B1narySolutions/amp-hardware/audio-board/rev3/fab/assembly/seed3-carrier_bom.csv

Comment | Designator | Footprint | JLCPCB Part #
Daisy Seed3 | A1 | Module:Electrosmith_Daisy_Seed
100pF | C1,C18 | Capacitor_SMD:C_0603_1608Metric | C14858
47nF | C2 | Capacitor_SMD:C_0805_2012Metric | C22402129
1nF | C3,C9 | Capacitor_SMD:C_0603_1608Metric | C163508
100nF | C4,C6,C17 | Capacitor_SMD:C_0603_1608Metric | C14663
47uF 16V | C5 | Capacitor_THT:CP_Radial_D5.0mm_P2.00mm
47uF 16V | C7 | Capacitor_SMD:C_1210_3225Metric | C77101
470n 25V C0G | C10,C11,C22,C23,C108,C109 | Capacitor_SMD:C_1206_3216Metric | C6049896
1uF | C12,C13,C14,C15 | Capacitor_SMD:C_0805_2012Metric | C28323
3.3nF | C16 | Capacitor_SMD:C_0603_1608Metric | C2170675
10pF | C19,C20 | Capacitor_SMD:C_0603_1608Metric | C1634
10u 16V | C21 | Capacitor_SMD:C_0805_2012Metric | C15850
10u 10V | C103 | Capacitor_SMD:C_0805_2012Metric | C15850
100n 10V | C105,C107,C123 | Capacitor_SMD:C_0603_1608Metric | C14663
1u 16V | C110 | Capacitor_SMD:C_0805_2012Metric | C28323
100u 25V | C111,C112 | Capacitor_THT:CP_Radial_D6.3mm_P2.50mm
100n 50V | C113,C114 | Capacitor_SMD:C_0603_1608Metric | C14663
1u 25V | C115 | Capacitor_SMD:C_0805_2012Metric | C28323
100n 25V | C116 | Capacitor_SMD:C_0603_1608Metric | C14663
220n 25V | C117,C118,C119,C120 | Capacitor_SMD:C_0603_1608Metric | C21120
680n 50V X7R | C121,C122 | Capacitor_SMD:C_0805_2012Metric | C22402009
1u 10V | C124,C125 | Capacitor_SMD:C_0805_2012Metric | C28323
PESD5V0S1BA | D1,D2,D3,D4,D5 | Diode_SMD:D_SOD-323 | C19224
BZT52C12 | D101 | Diode_SMD:D_SOD-123 | C668891
BAT54H | D102,D103 | Diode_SMD:D_SOD-323 | C179609
T3.15A | F101 | Seed3_Carrier:Fuse_Bel_0683G_4818
600R GHz | FB1 | Inductor_SMD:L_0603_1608Metric | C85830
220R@100MHz | FB101,FB102 | Inductor_SMD:L_0603_1608Metric | C76815
NRJ4HF | J1 | Connector_Audio:Jack_6.35mm_Neutrik_NRJ4HF_Horizontal
SJ3-35063AG | J2,J4 | Seed3_Carrier:Jack_3.5mm_SameSky_SJ3-35063AG_Horizontal
DISPLAY_UART | J3 | TerminalBlock_Phoenix:TerminalBlock_Phoenix_PT-1,5-3-3.5-H_1x03_P3.50mm_Horizontal
PJ-102AH | J101 | Connector_BarrelJack:BarrelJack_CUI_PJ-102AH_Horizontal
SPEAKER | J102 | TerminalBlock_Phoenix:TerminalBlock_Phoenix_PT-1,5-2-3.5-H_1x02_P3.50mm_Horizontal
DISPLAY 5V | J105 | TerminalBlock_Phoenix:TerminalBlock_Phoenix_PT-1,5-2-3.5-H_1x02_P3.50mm_Horizontal
DFR IN | J106 | Connector_JST:JST_XH_S2B-XH-A_1x02_P2.50mm_Horizontal
DFR OUT | J107 | TerminalBlock_Phoenix:TerminalBlock_Phoenix_PT-1,5-2-3.5-H_1x02_P3.50mm_Horizontal
BYPASS | JP101,JP103 | Connector_PinHeader_2.54mm:PinHeader_1x02_P2.54mm_Vertical
BULK | JP102,JP104 | Connector_PinHeader_2.54mm:PinHeader_1x02_P2.54mm_Vertical
RESET | JP105 | Connector_PinHeader_2.54mm:PinHeader_1x02_P2.54mm_Vertical
10uH | L101,L102 | Halliquest_Power:L_Bourns_SRP1038A_LeadFrame | C780184
2N7002 | Q2 | Package_TO_SOT_SMD:SOT-23 | C551416
IRF4905 | Q101 | Package_TO_SOT_THT:TO-220-3_Vertical
AO3401A | Q102 | Package_TO_SOT_SMD:SOT-23 | C15127
1M | R1 | Resistor_SMD:R_0603_1608Metric | C22935
1k | R2,R11,R21,R30 | Resistor_SMD:R_0603_1608Metric | C21190
10k | R3,R4,R6,R7,R8,R9,R101,R107,R109,R112,R113 | Resistor_SMD:R_0603_1608Metric | C25804
470 | R5,R20 | Resistor_SMD:R_0603_1608Metric | C23179
3.3k | R10 | Resistor_SMD:R_0603_1608Metric | C22978
100k | R12,R17,R18,R19,R24,R34,R111 | Resistor_SMD:R_0603_1608Metric | C25803
2.2 | R29 | Resistor_SMD:R_0603_1608Metric | C22939
2.2k | R32,R33,R108,R110 | Resistor_SMD:R_0603_1608Metric | C4190
100k 1% | R102 | Resistor_SMD:R_0603_1608Metric | C25803
10k 1% | R103 | Resistor_SMD:R_0603_1608Metric | C25804
5.6k 1% | R104 | Resistor_SMD:R_0603_1608Metric | C23189
0R | R105 | Resistor_SMD:R_2512_6332Metric | C189505
10R | R106 | Resistor_SMD:R_0603_1608Metric | C22859
18k | R114 | Resistor_SMD:R_0603_1608Metric | C25810
SPST | SW101 | TerminalBlock_Phoenix:TerminalBlock_Phoenix_PT-1,5-2-3.5-H_1x02_P3.50mm_Horizontal
TP_HP_DET | TP1 | TestPoint:TestPoint_Pad_D2.0mm
VBAT_PROTECTED | TP101 | TestPoint:TestPoint_Pad_D2.0mm
GND | TP102,TP105,TP107,TP108 | TestPoint:TestPoint_Pad_D2.0mm
AMP_PVCC | TP103 | TestPoint:TestPoint_Pad_D2.0mm
AMP_SDZ | TP104 | TestPoint:TestPoint_Pad_D2.0mm
+5V_RAW | TP106 | TestPoint:TestPoint_Pad_D2.0mm
AMP_FAULTZ | TP109 | TestPoint:TestPoint_Pad_D2.0mm
TLV9061QDBVRQ1 | U1 | Package_TO_SOT_SMD:SOT-23-5 | C22439604
TPA6130A2RTJR | U2 | Package_DFN_QFN:WQFN-20-1EP_4x4mm_P0.5mm_EP2.7x2.7mm | C130046
TPA3118D2DAPR | U101 | Halliquest_Power:TI_DAP0032C_HTSSOP32_P0.65mm_EP3.04x3.74mm | C46497
DFR0571 | U102
TPS3808EG50DBVR | U103 | Package_TO_SOT_SMD:SOT-23-6 | C30139374
