B1narySolutions/amp-hardware/audio-board/rev3/seed3-carrier-digikey-cart.csv

Quantity | Digi-Key Part Number | Customer Reference
1 | 311-1.00MHRCT-ND | R1
4 | 311-1.00KHRCT-ND | R2 R11 R21 R30
12 | RMCF0603FT10K0CT-ND | R3 R4 R6 R7 R8 R9 R101 R103 R107 R109 R112 ...
1 | RMCF0603FT18K0CT-ND | R114
1 | RMCF0603FT2R20CT-ND | R29
2 | 311-470HRCT-ND | R5 R20
1 | 311-3.30KHRCT-ND | R10
8 | RMCF0603FT100KCT-ND | R12 R17 R18 R19 R24 R34 R111 R102
1 | 311-5.60KHRCT-ND | R104
1 | RMCF0603FT10R0CT-ND | R106
4 | 311-2.20KHRCT-ND | R32 R33 R108 R110
2 | 1276-1008-1-ND | C1 C18
2 | 1276-1027-1-ND | C19 C20
1 | 399-C0805C473J3GACTUCT-ND | C2
1 | 490-1033-1-ND | FB1
2 | 1276-1091-1-ND | C3 C9
1 | 399-C0603C332J5GACTUCT-ND | C16
9 | 399-C0603C104K5RACTUCT-ND | C4 C6 C17 C105 C107 C113 C114 C116 C123
4 | 1276-CL10B224KB8NNNCCT-ND | C117 C118 C119 C120
8 | 399-C0805C105K5RACTUCT-ND | C12 C13 C14 C15 C110 C115 C124 C125
2 | 478-KGM21AR71C106KUCT-ND | C21 C103
6 | 490-GRM31C5C1E474JE01LCT-ND | C10 C11 C22 C23 C108 C109
2 | 399-C0805C684K5RACTUCT-ND | C121 C122
1 | 732-8628-1-ND | C5
1 | 490-6539-1-ND | C7
5 | 1727-PESD5V0S1BAFCT-ND | D1 D2 D3 D4 D5
2 | NSVBAT54HT1GOSCT-ND | D102 D103
1 | 6473-NRJ4HF-ND | J1
2 | 2223-SJ3-35063AG-ND | J2 J4
1 | 277-1722-ND | J3
4 | 277-1721-ND | J102 J105 J107 SW101
1 | 455-S2B-XH-A-ND | J106
1 | 455-2266-ND | J106 mate (DFR0571 input cable)
1 | 455-3241-ND | J106 cable leads (cut in half)
1 | 785-1001-1-ND | Q102
1 | 1727-8643-1-ND | Q2
1 | 296-TLV9061QDBVRQ1CT-ND | U1
1 | 296-21656-1-ND | U2
2 | S7018-ND | A1
4 | 10-EEU-FM1E101HCT-ND | C111 C112; C104 C106 optional
1 | YAG1232CT-ND | R105
1 | BZT52C12-TPMSCT-ND | D101
1 | IRF4905PBF-ND | Q101
1 | 296-38572-1-ND | U101
1 | 296-TPS3808EG50DBVRCT-ND | U103
2 | 445-MPZ1608S221ATA00CT-ND | FB101 FB102
2 | SRP1038A-100MCT-ND | L101 L102
1 | CP-102AH-ND | J101
5 | 952-2261-ND | JP101 JP102 JP103 JP104 JP105
4 | 952-2171-ND | JP101 JP102 JP103 JP104 shunts
1 | 5923-0683G3150-01CT-ND | F101
1 | 6281-S1B-ND | panel switch to SW101
1 | 1738-1442-ND | U102 off-board
