B1narySolutions/amp-hardware/audio-board/3dmodels/Bourns_PTV09A-4020F_placeholder.step

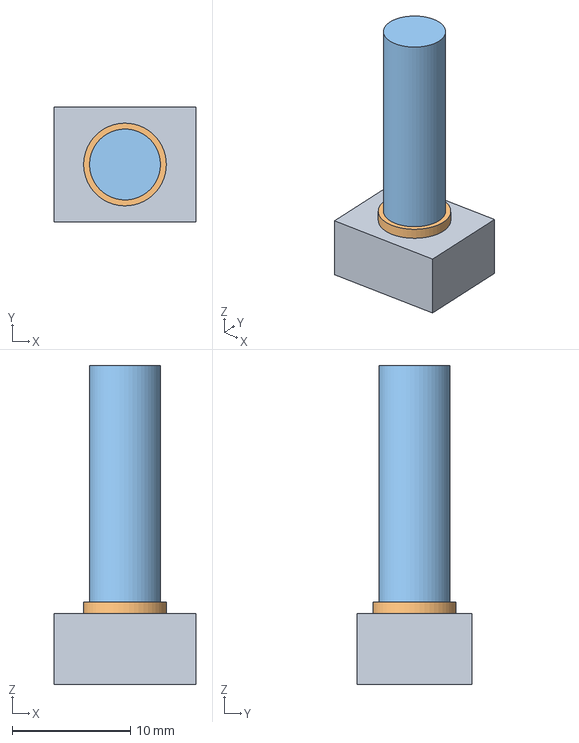
[picture p5: CAD file, 2026-10-25]
audio-board/3dmodels/Bourns_PTV09A-4020F_placeholder.step
12.0 x 9.70 x 27.0 mm
