B1narySolutions/amp-hardware/audio-board/3dmodels/Electrosmith_Daisy_Seed_placeholder.step

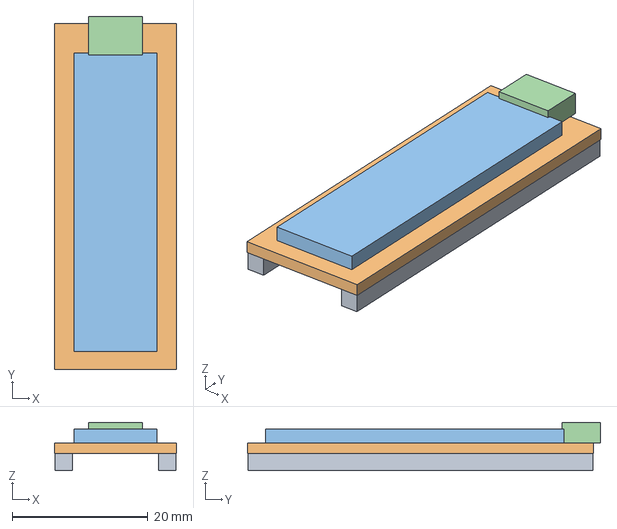
[picture p7: CAD file, 2026-10-25]
audio-board/3dmodels/Electrosmith_Daisy_Seed_placeholder.step
18.0 x 52.0 x 7.10 mm
