B1narySolutions/amp-hardware/legacy/audio-board/3dmodels/SameSky_SJ3-35063AG_placeholder.step

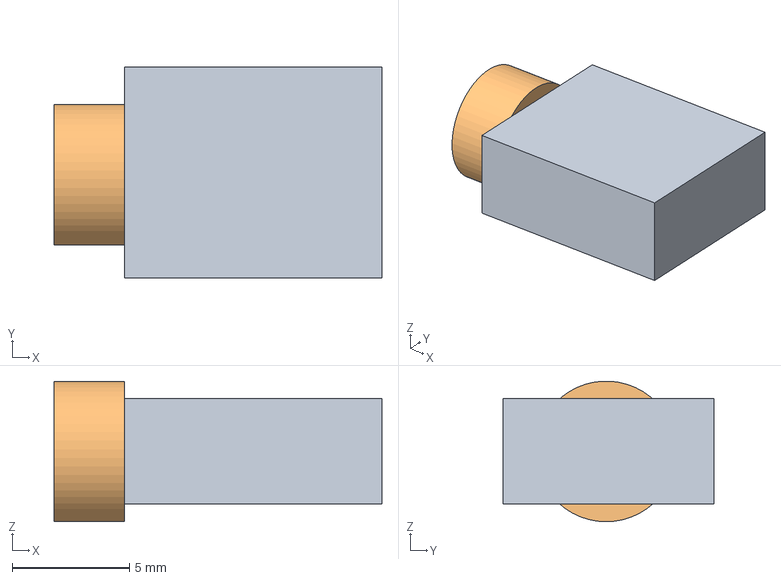
[picture p8: CAD file, 2026-11-10, an earlier design]
legacy/audio-board/3dmodels/SameSky_SJ3-35063AG_placeholder.step
14.0 x 9.00 x 5.99 mm
