B1narySolutions/amp-hardware/audio-board/rev3/TEST_PLAN.md

# Audio board rev 3 — Post-Assembly Test Plan

Bring-up and acceptance tests for one hand-assembled **rev 3** board, built from `seed3-carrier.kicad_sch` (sheet 2 is
`power.kicad_sch`), `fab/B1NARY_SOLUTIONS_gerber.zip` and `seed3-carrier-digikey.csv`. Record the package name in the log.
Expected numbers come from the rev 3 netlist and the parts' datasheets. `DESIGN.md` has the design and its reasons,
`CHANGES.md` the differences from audio rev 2 and power rev 1, and `../TEST_PLAN.md` is rev 2's plan. Stage 1A keeps rev 2's
item numbers so results compare across revisions.

Work through the stages in order and stop at the first failure: each stage assumes the one before it passed. Record results
in the log at the end (one copy per board serial). DESIGN.md "Open items" has audio rev 2 and power rev 1 brought up first:
set this board's jumpers and experiment parts from their results, and record the settings in the log.

## Powering rule: 12 V on J101, never 5 V alone on J107

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

## Circuit summary (what is being tested)

DESIGN.md describes each block, its parts and its values. The pinouts and probe points the tests use are below.

**Pinouts used below**

- U101 TPA3118D2 (HTSSOP-32, exposed pad = GND): 1 MODSEL (GND), 2 SDZ, 3 FAULTZ, 4 RINP, 5 RINN, 6 PLIMIT, 7 GVDD,
  8 GAIN/SLV, 9 GND, 10 LINP (GND), 11 LINN (GND), 12 MUTE, 13–15 AM2/AM1/AM0 (GND through JP106–JP108), 16 SYNC (not
  connected), 17 AVCC, 18/19 PVCC, 20 BSNL, 21 OUTNL, 22 GND, 23 OUTPL, 24 BSPL, 25 GND, 26 BSNR, 27 OUTNR, 28 GND,
  29 OUTPR, 30 BSPR, 31/32 PVCC. `OUT_P` = pins 27 + 29 (→ L101 → SPK+), `OUT_N` = pins 21 + 23 (→ L102 → SPK−)
- U103 TPS3808EG50 (SOT-23-6): 1 RESET (`AMP_PG`), 2 GND, 3 MR (`AMP_MR`, 90 kΩ internal pull-up), 4 CT (open: 20 ms),
  5 SENSE and 6 VDD (both `+5V_RAW`)
- Q101 IRF4905 (TO-220): 1 G, 2 D (SW101.2), 3 S (`VBAT_PROTECTED`). D101 (SOD-123): cathode on `VBAT_PROTECTED`, anode on
  Q101's gate
- Q102 AO3401A, Q2 2N7002 (SOT-23): 1 G, 2 S, 3 D. Q102: G GND, S `+5V_RAW`, D `+5V_DFR`. Q2: G `SPK_EN`, S GND, D `SPK_MUTE`
- U1 TLV9061 (SOT-23-5): 1 OUT, 2 V−, 3 IN+, 4 IN−, 5 V+
- U2 TPA6130A2 (WQFN-20, exposed pad 21 = GND): 1 LEFTINM, 2 LEFTINP, 3 GND, 4 RIGHTINP, 5 RIGHTINM, 6 SD, 7 SDA, 8 SCL,
  9/10 GND, 11 HPRIGHT, 12 VDD, 13 GND, 14 HPLEFT, 15/16 CPVSS, 17 CPN, 18 CPP, 19 GND, 20 VDD. − inputs from `HP_SOURCE`
  through C10 (left) and C11 (right); + inputs to GND through C22 (left) and C23 (right); both VDD pins on `HP_5V`; C13
  between CPP and CPN, C14 on CPVSS. Registers: 1 control (0xC0 = both outputs on, stereo), 2 volume and mutes (bits 7:6
  mute, 5:0 volume; 0x35 = +0.1 dB), 4 version (bits 3:0 read 0010)
- J101: 1 centre pin (+), 2 sleeve (GND), 3 switched contact (not connected). SW101: 1 from F101, 2 to Q101's drain
- D102, D103 BAT54H (SOD-323): 1 cathode (band) on `AMP_PVCC`; 2 anode, D102 on `AMP_SDZ`, D103 on `AMP_MUTE`. Both bands
  face right, D102's toward R105 and D103's toward R106
- Left edge, rear to front: J106 (JST XH header: 1 `VBAT_PROTECTED` "BAT+", marked with a triangle, 2 GND), J107
  (1 `+5V_DFR` "5V", 2 GND), J105 (1 `+5V_DISPLAY` "DISP", 2 GND), J3 (1 GND, 2 `UART_TX_CONN` TX, 3 `UART_RX_CONN` RX).
  J106 and J107 are the DFR0571's input and return
- J102 (right edge): 1 SPK−, 2 SPK+
- JP101: 1 `+5V_RAW`, 2 `+5V`. JP102: 1 `+5V`, 2 C104 `+`. JP103: 1 `+5V_RAW`, 2 `+5V_DISPLAY`. JP104: 1 `+5V_DISPLAY`,
  2 C106 `+`. JP105: 1 `AMP_MR`, 2 GND
- DFR0571 (U102, off-board): VIN+, GND, 5V OUT, GND. It isn't isolated: its two GND pads are one node
- J4 / J2 (SJ3-35063AG): 1 sleeve, 2 ring, 3 tip, 5 detect common, 6 detect NO (J2's 5/6 not connected)
- A1 (Daisy sockets, `A1.n` = Daisy pin n): 12 `I2C_SCL`, 13 `I2C_SDA`, 14 USART1 TX, 15 USART1 RX, 16 `AUDIO_IN_1`,
  17 `AUDIO_IN_2`, 18 `AUDIO_OUT_1`, 19 `AUDIO_OUT_2`, 20 GND, 22 `5V_SENSE`, 23 `HP_DETECT`, 25 `BATT_SENSE`, 27 `HP_SD`,
  28 `SPK_EN`, 32 `AMP_FAULTZ` through R30 (1k; input: low = speaker fault), 38 `3V3_D` (the I2C pull-ups), 39 `+5V`
  (VIN), 40 GND. All other pins are not connected. Probe the sockets while the Daisy is out; with it fitted the checks
  name a part on the same net
- Test points: TP1 `HP_DETECT`, TP101 `VBAT_PROTECTED`, TP103 `AMP_PVCC`, TP104 `AMP_SDZ`, TP106 `+5V_RAW`, TP109
  `AMP_FAULTZ`; TP102, TP105, TP107, TP108 GND
- Other probe points: `BATT_SENSE` at C17 pad 1 (or A1.25); `HP_5V` at C21 pad 1 or C12 pad 1; `+5V` on the power sheet's
  side of FB101 at C105 pad 1; `AMP_AVCC` at C115 pad 1; GVDD at C110 pad 1; `AMP_GAIN` at R104 pad 1; `AMP_PG` at R110
  pad 1; `AMP_MR` at JP105 pin 1; `SPK_MUTE` at R107 pad 2; U101's MUTE at C124 pad 1; `LINE_OUT`/`LINE_REF` at C108/C109
  pad 1 and U101's inputs at their pad 2; `OUT_P`/`OUT_N` at L101/L102 pad 1; the bootstrap pins at C117–C120 pad 1
  (`BSPR`, `BSNR`, `BSPL`, `BSNL`; pad 2 is the output); Q101's gate at R101 pad 1

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

| Option | Default for bring-up | Readings it moves |
|---|---|---|
| JP101 / JP103 (bead bypass) | Open (beads in) | 1.34 only detects a missing bead with these open |
| JP102 / JP104 (optional bulk) | Open; C104 and C106 are DNP | None until C104/C106 are fitted (3D.2) |
| JP105 (manual reset) | Open (shunted only in 3B and to clear a fault) | Shunted: SDZ held low, `AMP_MR` → GND 0 Ω, TP106 → GND ≈ 4.7 kΩ |
| F101 | Bel 0683G3150-01, T3.15A SMD, soldered (no holder, no spare values) | None |
| R105 | 0 Ω RC2512JK-070RL (2 A); spare CRCW2512 0 Ω | None |
| R106 (AVCC filter) | 10 Ω, 0603; no spares in rev 3's order (the earlier build's 4.7 Ω and 22 Ω are 1206 and don't fit) | 1.31: TP103 → C115 pad 1 |
| C108/C109 | 470 nF 25 V C0G, 1206 (GRM31C5C1E474JE01L); no spare pair in the order | None (4C.4 checks the 20 Hz loss) |
| C121/C122 | 680 nF, 0805; no spare pair in rev 3's order (the earlier build's 470 nF pair is 1206 and doesn't fit) | 4C.4: filter corner 61 kHz; a 470 nF pair would move it to 73 kHz |
| L101/L102 | 10 µH; spare pairs 6.8 µH, 15 µH | 4C.3/4C.4: corner 74 / 50 kHz, ripple up / down |

## Equipment

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

## Stage 0 — Visual and mechanical inspection (unpowered, no Daisy, no DFR0571)

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

## Stage 1 — Unpowered resistance checks (no Daisy, no DFR0571)

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

**1A. Audio section (rev 2's item numbers, where rev 2 has the same check)**

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

**1B. Power section**

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

**1C. U101 and U103 neighbouring pins**

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

## Stage 2 — Battery side, DFR0571 disconnected

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

## Stage 3 — The DFR0571 and the 5 V rails, Daisy removed

**3A. The DFR0571 on its own (off the board)**

U1 and U2 are rated 5.5 V, U103 6 V, and the 5 V contract (`power-board/README.md`) is 4.75–5.25 V. The module has no
short-circuit or reverse protection (DESIGN.md "5 V supply and distribution" has its datasheet figures).

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

**3B. On the board, U101 held in shutdown**

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

**3C. U101 enabled, muted**

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

**3D. 5 V filter options**

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

Return the jumpers to the defaults (or to what rev 1's bring-up chose) before going on.

## Stage 4 — Analog paths and speaker amp, Daisy removed

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

**4A. Guitar input buffer (J1 → AUDIO_IN_1)**

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

**4B. Headphone filter + headphone amp (AUDIO_OUT_1 → J4)**

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

**4C. Speaker send and speaker amp (AUDIO_OUT_2 → U101 → J102)**

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

Power off before disconnecting the load.

**4D. AUX input (J2 → AUDIO_IN_2)**

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

Remove the injected signal and the A1.28 pull-up before going on.

## Stage 5 — Power-up with Daisy fitted

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

## Stage 6 — Functional tests with test firmware

Flash a small bring-up program (libDaisy or Arduino/DaisyDuino) over USB that:

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

## Stage 7 — Soak and robustness

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

## Stage 8 — Pops, hiss and mute

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

## Fault-finding hints

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

## Results log

Board serial / ID: __________  Assembled by: __________  Date: __________

Fab package: __________  Tested by: __________  Firmware commit: __________

DFR0571 (marking / serial): __________  Battery 12 V output: full ______ V, near empty ______ V

**Options fitted on this board** (note in the stage rows if a setting changed between stages)

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

Rework performed:

Open issues:
