B1narySolutions/amp-hardware/amp-board/amp-board.kicad_pcb

## KiCad design amp-board/amp-board.kicad_pcb (2026-11-10)

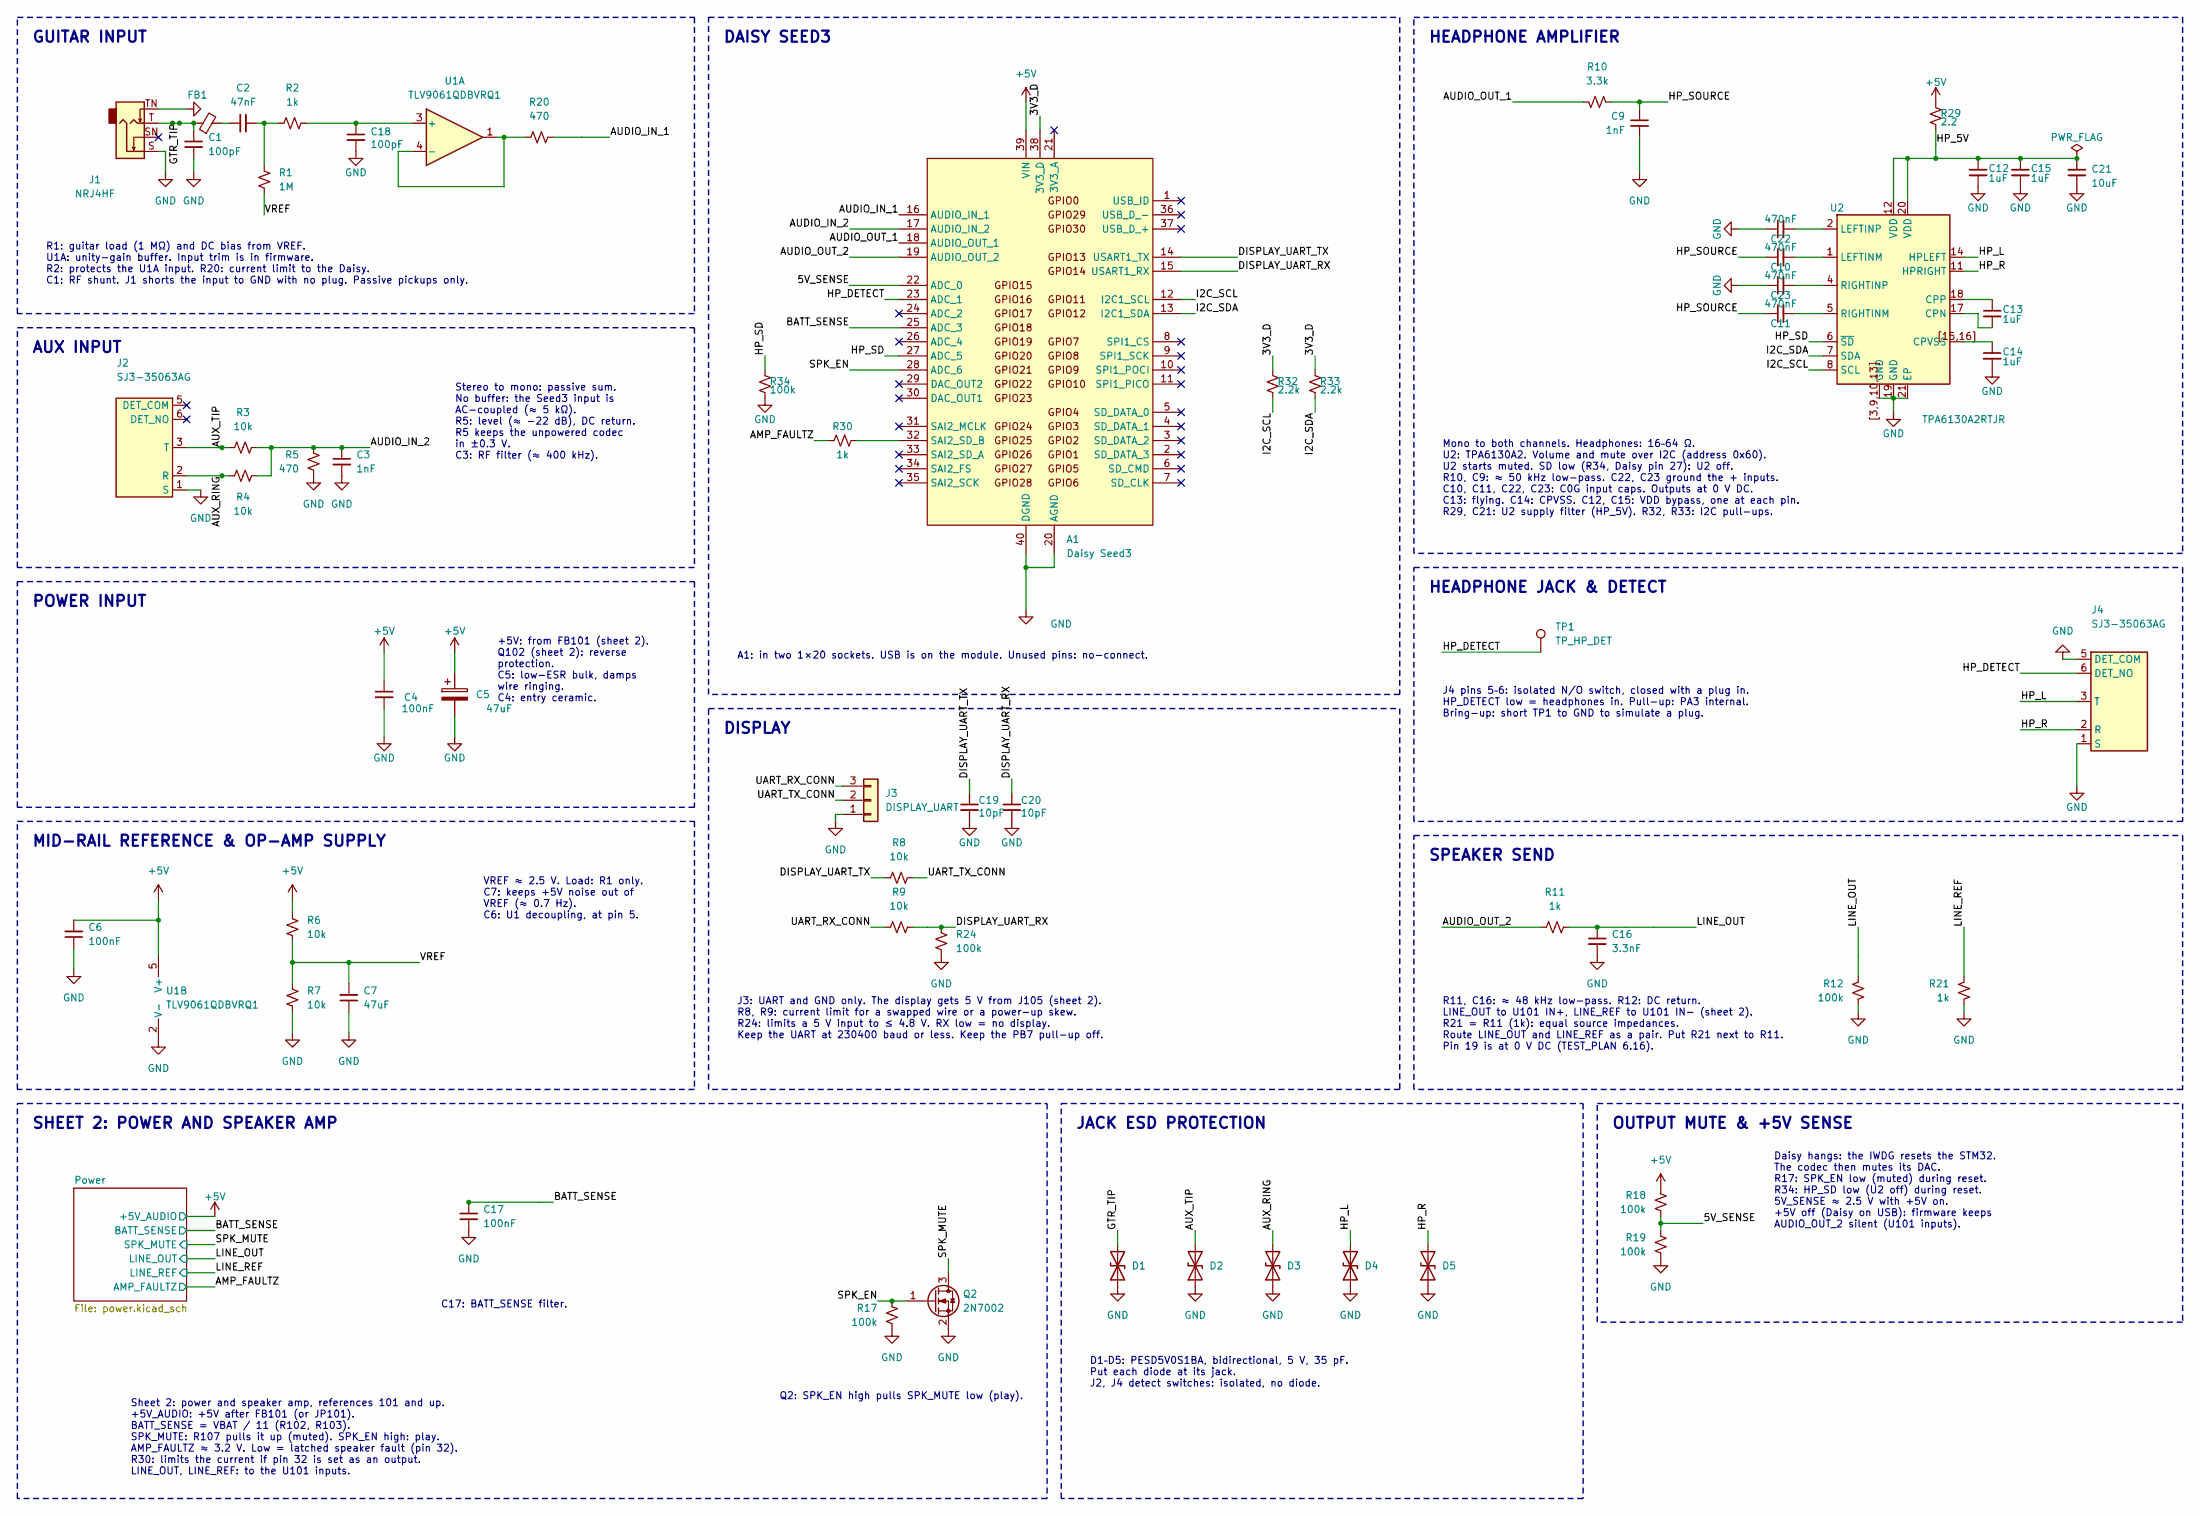
[picture p9: schematic amp-board.kicad_sch, Amp board]

Parts:
A1: Daisy Seed3; Electrosmith_Daisy_Seed
C1, C18: 100pF; C_0603_1608Metric; Voltage 50V; MPN CL10C101JB8NNNC; DigiKey 1276-1008-1-ND
C2: 47nF; C_0805_2012Metric; Voltage 25V; MPN C0805C473J3GACTU; DigiKey 399-C0805C473J3GACTUCT-ND
C3, C9: 1nF; C_0603_1608Metric; Voltage 50V; MPN CL10C102JB8NNNC; DigiKey 1276-1091-1-ND
C4, C6, C17: 100nF; C_0603_1608Metric; Voltage 50V; MPN C0603C104K5RACTU; DigiKey 399-C0603C104K5RACTUCT-ND
C5: 47uF; CP_Radial_D5.0mm_P2.00mm; Voltage 16V; MPN 860010472005; DigiKey 732-8628-1-ND
C7: 47uF; C_1210_3225Metric; Voltage 16V; MPN GRM32ER61C476KE15L; DigiKey 490-6539-1-ND
C10, C11, C22, C23: 470nF; C_1206_3216Metric; Voltage 25V; MPN GRM31C5C1E474JE01L; DigiKey 490-GRM31C5C1E474JE01LCT-ND
C12, C13, C14, C15: 1uF; C_0805_2012Metric; Voltage 50V; MPN C0805C105K5RACTU; DigiKey 399-C0805C105K5RACTUCT-ND
C16: 3.3nF; C_0603_1608Metric; Voltage 50V; MPN C0603C332J5GACTU; DigiKey 399-C0603C332J5GACTUCT-ND
C19, C20: 10pF; C_0603_1608Metric; Voltage 50V; MPN CL10C100JB8NNNC; DigiKey 1276-1027-1-ND
C21: 10uF; C_0805_2012Metric; Voltage 16V; MPN KGM21AR71C106KU; DigiKey 478-KGM21AR71C106KUCT-ND
D1, D2, D3, D4, D5: PESD5V0S1BA; D_SOD-323; MPN PESD5V0S1BAF; DigiKey 1727-PESD5V0S1BAFCT-ND
FB1: 600R GHz; L_0603_1608Metric; MPN BLM18HG601SN1D; DigiKey 490-1033-1-ND
J1: NRJ4HF; Jack_6.35mm_Neutrik_NRJ4HF_Horizontal; MPN NRJ4HF; DigiKey 6473-NRJ4HF-ND
J2, J4: SJ3-35063AG; Jack_3.5mm_SameSky_SJ3-35063AG_Horizontal; MPN SJ3-35063AG; DigiKey 2223-SJ3-35063AG-ND
J3: DISPLAY_UART; TerminalBlock_Phoenix_PT-1,5-3-3.5-H_1x03_P3.50mm_Horizontal; MPN 1984620; DigiKey 277-1722-ND
Q2: 2N7002; SOT-23; MPN 2N7002NXAKR; DigiKey 1727-8643-1-ND
R1: 1M; R_0603_1608Metric; MPN RC0603FR-071ML; DigiKey 311-1.00MHRCT-ND
R2, R11, R21, R30: 1k; R_0603_1608Metric; MPN RC0603FR-071KL; DigiKey 311-1.00KHRCT-ND
R3, R4, R6, R7, R8, R9: 10k; R_0603_1608Metric; MPN RMCF0603FT10K0; DigiKey RMCF0603FT10K0CT-ND
R5, R20: 470; R_0603_1608Metric; MPN RC0603FR-07470RL; DigiKey 311-470HRCT-ND
R10: 3.3k; R_0603_1608Metric; MPN RC0603FR-073K3L; DigiKey 311-3.30KHRCT-ND
R12, R17, R18, R19, R24, R34: 100k; R_0603_1608Metric; MPN RMCF0603FT100K; DigiKey RMCF0603FT100KCT-ND
R29: 2.2; R_0603_1608Metric; MPN RMCF0603FT2R20; DigiKey RMCF0603FT2R20CT-ND
R32, R33: 2.2k; R_0603_1608Metric; MPN RC0603FR-072K2L; DigiKey 311-2.20KHRCT-ND
TP1: TP_HP_DET; TestPoint_Pad_D2.0mm
U1: TLV9061QDBVRQ1; SOT-23-5; MPN TLV9061QDBVRQ1; DigiKey 296-TLV9061QDBVRQ1CT-ND
U2: TPA6130A2RTJR; WQFN-20-1EP_4x4mm_P0.5mm_EP2.7x2.7mm; MPN TPA6130A2RTJR; DigiKey 296-21656-1-ND

Connections:
+5V: A1.39 (VIN), C4.1, C5.1, C6.2, R6.1, R18.1, R29.1, U1.5 (V+); also elsewhere on the board
/3V3_D: A1.38 (3V3_D), R32.1, R33.1
/5V_SENSE: A1.22 (ADC_0), R18.2, R19.1
/AMP_FAULTZ: R30.1; also elsewhere on the board
/AUDIO_IN_1: A1.16 (AUDIO_IN_1), R20.2
/AUDIO_IN_2: A1.17 (AUDIO_IN_2), C3.1, R3.2, R4.2, R5.1
/AUDIO_OUT_1: A1.18 (AUDIO_OUT_1), R10.2
/AUDIO_OUT_2: A1.19 (AUDIO_OUT_2), R11.1
/AUX_RING: D3.2 (A2), J2.2 (R), R4.1
/AUX_TIP: D2.2 (A2), J2.3 (T), R3.1
/BATT_SENSE: A1.25 (ADC_3), C17.1; also elsewhere on the board
/DISPLAY_UART_RX: A1.15 (USART1_RX), C20.1, R9.2, R24.1
/DISPLAY_UART_TX: A1.14 (USART1_TX), C19.1, R8.1
/GTR_TIP: C1.1, D1.2 (A2), FB1.1, J1.T
/HP_5V: C12.1, C15.1, C21.1, R29.2, U2.12 (VDD), U2.20 (VDD)
/HP_DETECT: A1.23 (ADC_1), J4.6 (DET_NO), TP1.1 (1_1)
/HP_L: D4.2 (A2), J4.3 (T), U2.14 (HPLEFT)
/HP_R: D5.2 (A2), J4.2 (R), U2.11 (HPRIGHT)
/HP_SD: A1.27 (ADC_5), R34.1, U2.6 (~SD)
/HP_SOURCE: C9.1, C10.1, C11.1, R10.1
/I2C_SCL: A1.12 (I2C1_SCL), R32.2, U2.8 (SCL)
/I2C_SDA: A1.13 (I2C1_SDA), R33.2, U2.7 (SDA)
/LINE_OUT: C16.1, R11.2, R12.2; also elsewhere on the board
/LINE_REF: R21.2; also elsewhere on the board
/SPK_EN: A1.28 (ADC_6), Q2.1 (G), R17.1
/SPK_MUTE: Q2.3 (D); also elsewhere on the board
/UART_RX_CONN: J3.3, R9.1
/UART_TX_CONN: J3.2, R8.2
/VREF: C7.2, R1.2, R6.2, R7.1
GND: A1.20 (AGND), A1.40 (DGND), C1.2, C3.2, C4.2, C5.2, C6.1, C7.1, C9.2, C12.2, C14.2, C15.2, C16.2, C17.2, C18.2, C19.2, C20.2, C21.2, C22.1, C23.1, D1.1 (A1), D2.1 (A1), D3.1 (A1), D4.1 (A1), D5.1 (A1), J1.S, J1.TN, J2.1 (S), J3.1, J4.1 (S), J4.5 (DET_COM), Q2.2 (S), R5.2, R7.2, R12.1, R17.2, R19.2, R21.1, R24.2, R34.2, U1.2 (V-), U2.3, U2.9, U2.10, U2.13, U2.19 (GND), U2.21 (EP), U2.[3,9,10,13] (GND); also elsewhere on the board
unnamed: A1.32 (SAI2_SD_B), R30.2
unnamed: C2.1, FB1.2
unnamed: C2.2, R1.1, R2.1
unnamed: C18.1, R2.2, U1.3 (+)
unnamed: R20.1, U1.1, U1.4 (-)
unnamed: C13.2, U2.17 (CPN)
unnamed: C13.1, U2.18 (CPP)
unnamed: C14.1, U2.15, U2.16, U2.[15,16] (CPVSS)
unnamed: C10.2, U2.1 (LEFTINM)
unnamed: C22.2, U2.2 (LEFTINP)
unnamed: C11.2, U2.5 (RIGHTINM)
unnamed: C23.2, U2.4 (RIGHTINP)

Notes on the sheet:
GUITAR INPUT
AUX INPUT
POWER INPUT
MID-RAIL REFERENCE & OP-AMP SUPPLY
DAISY SEED3
DISPLAY
HEADPHONE AMPLIFIER
HEADPHONE JACK & DETECT
SPEAKER SEND
SHEET 2: POWER AND SPEAKER AMP
OUTPUT MUTE & +5V SENSE
R1: guitar load (1 MΩ) and DC bias from VREF. U1A: unity-gain buffer. Input trim is in firmware. R2: protects the U1A input. R20: current limit to the Daisy. C1: RF shunt. J1 shorts the input to GND with no plug. Passive pickups only.
Stereo to mono: passive sum. No buffer: the Seed3 input is AC-coupled (≈ 5 kΩ). R5: level (≈ −22 dB), DC return. R5 keeps the unpowered codec in ±0.3 V. C3: RF filter (≈ 400 kHz).
+5V: from FB101 (sheet 2). Q102 (sheet 2): reverse protection. C5: low-ESR bulk, damps wire ringing. C4: entry ceramic.
VREF ≈ 2.5 V. Load: R1 only. C7: keeps +5V noise out of VREF (≈ 0.7 Hz). C6: U1 decoupling, at pin 5.
A1: in two 1×20 sockets. USB is on the module. Unused pins: no-connect.
J3: UART and GND only. The display gets 5 V from J105 (sheet 2). R8, R9: current limit for a swapped wire or a power-up skew. R24: limits a 5 V input to ≤ 4.8 V. RX low = no display. Keep the UART at 230400 baud or less. Keep the PB7 pull-up off.
Mono to both channels. Headphones: 16–64 Ω. U2: TPA6130A2. Volume and mute over I2C (address 0x60). U2 starts muted. SD low (R34, Daisy pin 27): U2 off. R10, C9: ≈ 50 kHz low-pass. C22, C23 ground the + inputs. C10, C11, C22, C23: C0G input caps. Outputs at 0 V DC. C13: flying. C14: CPVSS. C12, C15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
J4 pins 5–6: isolated N/O switch, closed with a plug in. HP_DETECT low = headphones in. Pull-up: PA3 internal. Bring-up: short TP1 to GND to simulate a plug.
R11, C16: ≈ 48 kHz low-pass. R12: DC return. LINE_OUT to U101 IN+, LINE_REF to U101 IN− (sheet 2). R21 = R11 (1k): equal source impedances. Route LINE_OUT and LINE_REF as a pair. Put R21 next to R11. Pin 19 is at 0 V DC (TEST_PLAN 6.16).
Sheet 2: power and speaker amp, references 101 and up. +5V_AUDIO: +5V after FB101 (or JP101). BATT_SENSE = VBAT / 11 (R102, R103). SPK_MUTE: R107 pulls it up (muted). SPK_EN high: play. AMP_FAULTZ ≈ 3.2 V. Low = latched speaker fault (pin 32). R30: limits the current if pin 32 is set as an output. 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
Daisy hangs: the IWDG resets the STM32. The codec then mutes its DAC. R17: SPK_EN low (muted) during reset. R34: HP_SD low (U2 off) during reset. 5V_SENSE ≈ 2.5 V with +5V on. +5V off (Daisy on USB): firmware keeps AUDIO_OUT_2 silent (U101 inputs).
JACK ESD PROTECTION
D1–D5: PESD5V0S1BA, bidirectional, 5 V, 35 pF. Put each diode at its jack. J2, J4 detect switches: isolated, no diode.
C17: BATT_SENSE filter.
Q2: SPK_EN high pulls SPK_MUTE low (play).

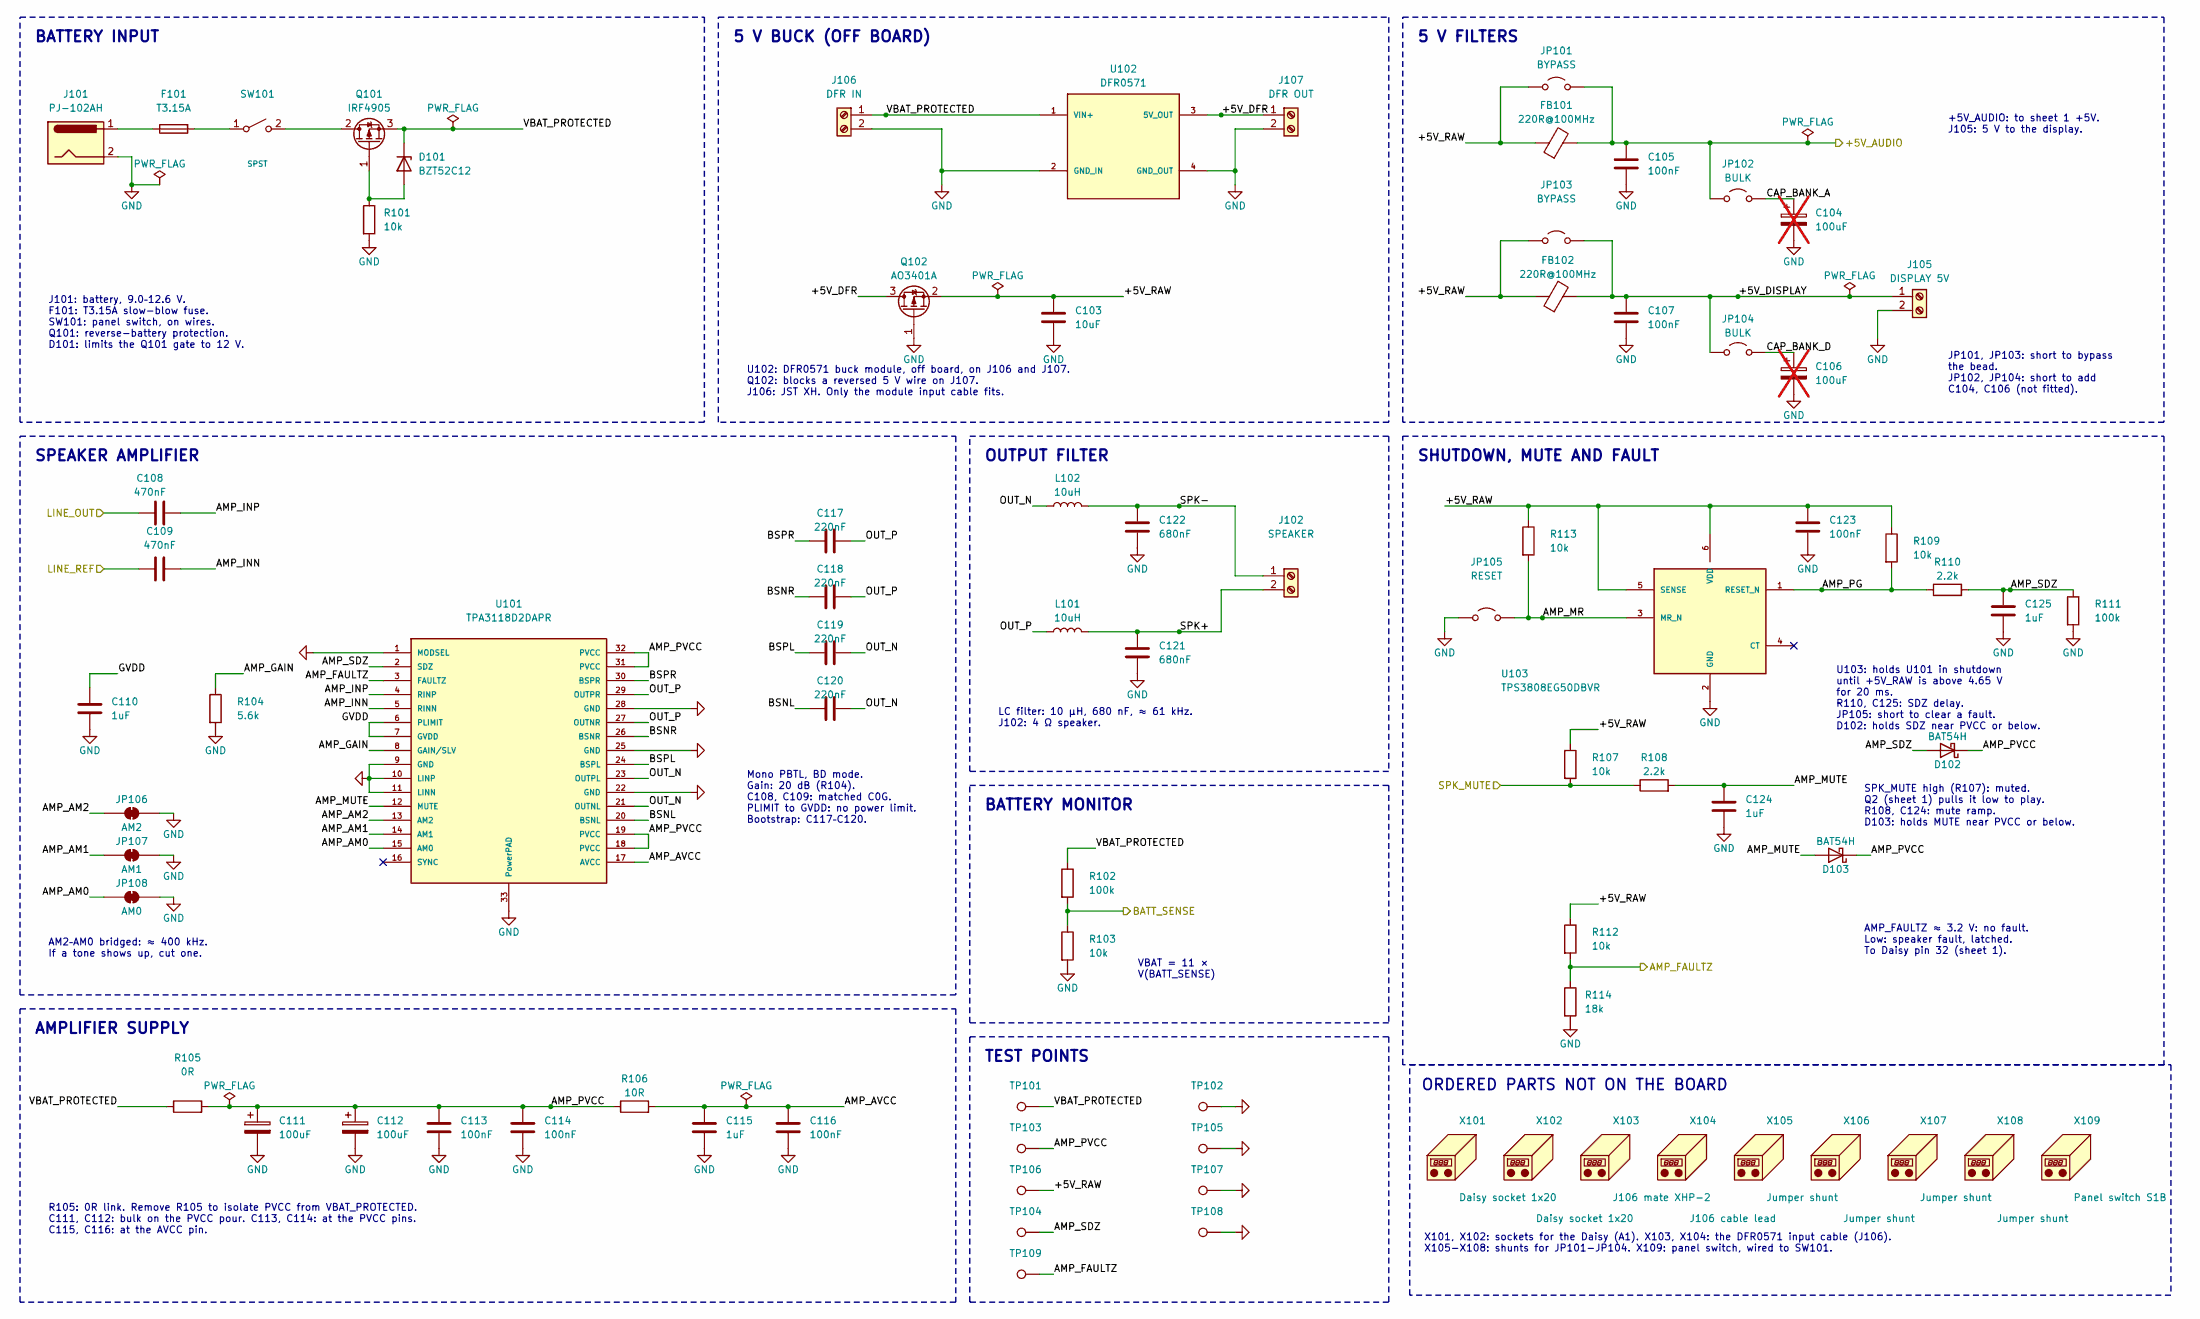
[picture p10: schematic power.kicad_sch, Power and speaker amp]

Parts:
C103: 10uF; C_0805_2012Metric; Voltage 16V; MPN KGM21AR71C106KU; DigiKey 478-KGM21AR71C106KUCT-ND
C104, C106: 100uF; CP_Radial_D6.3mm_P2.50mm; Voltage 25V; MPN EEU-FM1E101H; DigiKey 10-EEU-FM1E101HCT-ND; not fitted
C105, C107, C113, C114, C116, C123: 100nF; C_0603_1608Metric; Voltage 50V; MPN C0603C104K5RACTU; DigiKey 399-C0603C104K5RACTUCT-ND
C108, C109: 470nF; C_1206_3216Metric; Voltage 25V; MPN GRM31C5C1E474JE01L; DigiKey 490-GRM31C5C1E474JE01LCT-ND
C110, C115, C124, C125: 1uF; C_0805_2012Metric; Voltage 50V; MPN C0805C105K5RACTU; DigiKey 399-C0805C105K5RACTUCT-ND
C111, C112: 100uF; CP_Radial_D6.3mm_P2.50mm; Voltage 25V; MPN EEU-FM1E101H; DigiKey 10-EEU-FM1E101HCT-ND
C117, C118, C119, C120: 220nF; C_0603_1608Metric; Voltage 50V; MPN CL10B224KB8NNNC; DigiKey 1276-CL10B224KB8NNNCCT-ND
C121, C122: 680nF; C_0805_2012Metric; Voltage 50V; MPN C0805C684K5RACTU; DigiKey 399-C0805C684K5RACTUCT-ND
D101: BZT52C12; D_SOD-123; MPN BZT52C12-TP; LCSC C668891
D102, D103: BAT54H; D_SOD-323; MPN NSVBAT54HT1G; DigiKey NSVBAT54HT1GOSCT-ND
F101: T3.15A; Fuse_Bel_0683G_4818; MPN 0683G3150-01; DigiKey 5923-0683G3150-01CT-ND
FB101, FB102: 220R@100MHz; L_0603_1608Metric; MPN MPZ1608S221ATA00; LCSC C76815
J101: PJ-102AH; BarrelJack_CUI_PJ-102AH_Horizontal; MPN PJ-102AH; DigiKey CP-102AH-ND
J102: SPEAKER; TerminalBlock_Phoenix_PT-1,5-2-3.5-H_1x02_P3.50mm_Horizontal; MPN 1984617; DigiKey 277-1721-ND
J105: DISPLAY 5V; TerminalBlock_Phoenix_PT-1,5-2-3.5-H_1x02_P3.50mm_Horizontal; MPN 1984617; DigiKey 277-1721-ND
J106: DFR IN; JST_XH_S2B-XH-A_1x02_P2.50mm_Horizontal; MPN S2B-XH-A; DigiKey 455-S2B-XH-A-ND
J107: DFR OUT; TerminalBlock_Phoenix_PT-1,5-2-3.5-H_1x02_P3.50mm_Horizontal; MPN 1984617; DigiKey 277-1721-ND
JP101, JP103: BYPASS; PinHeader_1x02_P2.54mm_Vertical; MPN M20-9990245; DigiKey 952-2261-ND
JP102, JP104: BULK; PinHeader_1x02_P2.54mm_Vertical; MPN M20-9990245; DigiKey 952-2261-ND
JP105: RESET; PinHeader_1x02_P2.54mm_Vertical; MPN M20-9990245; DigiKey 952-2261-ND
JP106: AM2; SolderJumper-2_P1.3mm_Bridged_RoundedPad1.0x1.5mm
JP107: AM1; SolderJumper-2_P1.3mm_Bridged_RoundedPad1.0x1.5mm
JP108: AM0; SolderJumper-2_P1.3mm_Bridged_RoundedPad1.0x1.5mm
L101, L102: 10uH; L_Bourns_SRP1038A_LeadFrame; MPN SRP1038A-100M; LCSC C780184
Q101: IRF4905; TO-220-3_Vertical; MPN IRF4905PBF; DigiKey IRF4905PBF-ND
Q102: AO3401A; SOT-23; MPN AO3401A; DigiKey 785-1001-1-ND
R101, R103, R107, R109, R112, R113: 10k; R_0603_1608Metric; MPN RMCF0603FT10K0; DigiKey RMCF0603FT10K0CT-ND
R102, R111: 100k; R_0603_1608Metric; MPN RMCF0603FT100K; DigiKey RMCF0603FT100KCT-ND
R104: 5.6k; R_0603_1608Metric; MPN RC0603FR-075K6L; DigiKey 311-5.60KHRCT-ND
R105: 0R; R_2512_6332Metric; MPN RC2512JK-070RL; LCSC C189505
R106: 10R; R_0603_1608Metric; MPN RMCF0603FT10R0; DigiKey RMCF0603FT10R0CT-ND
R108, R110: 2.2k; R_0603_1608Metric; MPN RC0603FR-072K2L; DigiKey 311-2.20KHRCT-ND
R114: 18k; R_0603_1608Metric; MPN RMCF0603FT18K0; DigiKey RMCF0603FT18K0CT-ND
SW101: SPST; TerminalBlock_Phoenix_PT-1,5-2-3.5-H_1x02_P3.50mm_Horizontal; MPN 1984617; DigiKey 277-1721-ND
TP101: VBAT_PROTECTED; TestPoint_Pad_D2.0mm
TP102, TP105, TP107, TP108: GND; TestPoint_Pad_D2.0mm
TP103: AMP_PVCC; TestPoint_Pad_D2.0mm
TP104: AMP_SDZ; TestPoint_Pad_D2.0mm
TP106: +5V_RAW; TestPoint_Pad_D2.0mm
TP109: AMP_FAULTZ; TestPoint_Pad_D2.0mm
U101: TPA3118D2DAPR; TI_DAP0032C_HTSSOP32_P0.65mm_EP3.04x3.74mm; MPN TPA3118D2DAPR; LCSC C46497
U102: DFR0571; MPN DFR0571; DigiKey 1738-1442-ND
U103: TPS3808EG50DBVR; SOT-23-6; MPN TPS3808EG50DBVR; LCSC C30139374
X101, X102: Daisy socket 1x20; MPN PPTC201LFBN-RC; DigiKey S7018-ND
X103: J106 mate XHP-2; MPN XHP-2; DigiKey 455-2266-ND
X104: J106 cable lead; MPN ASXHSXH22K305; DigiKey 455-3241-ND
X105, X106, X107, X108: Jumper shunt; MPN M7567-05; DigiKey 952-2171-ND
X109: Panel switch S1B; MPN S1B; DigiKey 6281-S1B-ND

Connections:
+5V: C105.1, FB101.2, JP101.2 (B), JP102.1 (A); also elsewhere on the board
/AMP_FAULTZ: R112.2, R114.1, TP109.1, U101.3 (FAULTZ); also elsewhere on the board
/BATT_SENSE: R102.2, R103.1; also elsewhere on the board
/LINE_OUT: C108.1; also elsewhere on the board
/LINE_REF: C109.1; also elsewhere on the board
/Power/+5V_DFR: J107.1, Q102.3 (D), U102.3 (5V_OUT)
/Power/+5V_DISPLAY: C107.1, FB102.2, J105.1, JP103.2 (B), JP104.1 (A)
/Power/+5V_RAW: C103.1, C123.1, FB101.1, FB102.1, JP101.1 (A), JP103.1 (A), Q102.2 (S), R107.1, R109.1, R112.1, R113.1, TP106.1, U103.5 (SENSE), U103.6 (VDD)
/Power/AMP_AM0: JP108.1 (A), U101.15 (AM0)
/Power/AMP_AM1: JP107.1 (A), U101.14 (AM1)
/Power/AMP_AM2: JP106.1 (A), U101.13 (AM2)
/Power/AMP_AVCC: C115.1, C116.1, R106.2, U101.17 (AVCC)
/Power/AMP_GAIN: R104.1, U101.8 (GAIN/SLV)
/Power/AMP_INN: C109.2, U101.5 (RINN)
/Power/AMP_INP: C108.2, U101.4 (RINP)
/Power/AMP_MR: JP105.1 (A), R113.2, U103.3 (MR_N)
/Power/AMP_MUTE: C124.1, D103.2 (A), R108.2, U101.12 (MUTE)
/Power/AMP_PG: R109.2, R110.1, U103.1 (RESET_N)
/Power/AMP_PVCC: C111.1, C112.1, C113.1, C114.1, D102.1 (K), D103.1 (K), R105.2, R106.1, TP103.1, U101.18 (PVCC), U101.19 (PVCC), U101.31 (PVCC), U101.32 (PVCC)
/Power/AMP_SDZ: C125.1, D102.2 (A), R110.2, R111.1, TP104.1, U101.2 (SDZ)
/Power/BSNL: C120.1, U101.20 (BSNL)
/Power/BSNR: C118.1, U101.26 (BSNR)
/Power/BSPL: C119.1, U101.24 (BSPL)
/Power/BSPR: C117.1, U101.30 (BSPR)
/Power/CAP_BANK_A: C104.1, JP102.2 (B)
/Power/CAP_BANK_D: C106.1, JP104.2 (B)
/Power/GVDD: C110.1, U101.6 (PLIMIT), U101.7 (GVDD)
/Power/OUT_N: C119.2, C120.2, L102.1, U101.21 (OUTNL), U101.23 (OUTPL)
/Power/OUT_P: C117.2, C118.2, L101.1, U101.27 (OUTNR), U101.29 (OUTPR)
/Power/SPK+: C121.1, J102.2, L101.2
/Power/SPK-: C122.1, J102.1, L102.2
/Power/VBAT_PROTECTED: D101.1 (K), J106.1, Q101.3 (S), R102.1, R105.1, TP101.1, U102.1 (VIN+)
/SPK_MUTE: R107.2, R108.1; also elsewhere on the board
GND: C103.2, C104.2, C105.2, C106.2, C107.2, C110.2, C111.2, C112.2, C113.2, C114.2, C115.2, C116.2, C121.2, C122.2, C123.2, C124.2, C125.2, J101.2, J105.2, J106.2, J107.2, JP105.2 (B), JP106.2 (B), JP107.2 (B), JP108.2 (B), Q102.1 (G), R101.2, R103.2, R104.2, R111.2, R114.2, TP102.1, TP105.1, TP107.1, TP108.1, U101.1 (MODSEL), U101.9 (GND), U101.10 (LINP), U101.11 (LINN), U101.22 (GND), U101.25 (GND), U101.28 (GND), U101.33 (PowerPAD), U102.2 (GND_IN), U102.4 (GND_OUT), U103.2 (GND); also elsewhere on the board
unnamed: D101.2 (A), Q101.1 (G), R101.1
unnamed: F101.1, J101.1
unnamed: Q101.2 (D), SW101.2 (B)
unnamed: F101.2, SW101.1 (A)

Notes on the sheet:
BATTERY INPUT
J101: battery, 9.0–12.6 V. F101: T3.15A slow-blow fuse. SW101: panel switch, on wires. Q101: reverse-battery protection. D101: limits the Q101 gate to 12 V.
5 V BUCK (OFF BOARD)
U102: DFR0571 buck module, off board, on J106 and J107. Q102: blocks a reversed 5 V wire on J107. J106: JST XH. Only the module input cable fits.
5 V FILTERS
+5V_AUDIO: to sheet 1 +5V. J105: 5 V to the display.
JP101, JP103: short to bypass the bead. JP102, JP104: short to add C104, C106 (not fitted).
SPEAKER AMPLIFIER
AM2–AM0 bridged: ≈ 400 kHz. If a tone shows up, cut one.
Mono PBTL, BD mode. Gain: 20 dB (R104). C108, C109: matched C0G. PLIMIT to GVDD: no power limit. Bootstrap: C117–C120.
AMPLIFIER SUPPLY
R105: 0R link. Remove R105 to isolate PVCC from VBAT_PROTECTED. C111, C112: bulk on the PVCC pour. C113, C114: at the PVCC pins. C115, C116: at the AVCC pin.
OUTPUT FILTER
LC filter: 10 µH, 680 nF, ≈ 61 kHz. J102: 4 Ω speaker.
BATTERY MONITOR
VBAT = 11 × V(BATT_SENSE)
TEST POINTS
SHUTDOWN, MUTE AND FAULT
U103: holds U101 in shutdown until +5V_RAW is above 4.65 V for 20 ms. R110, C125: SDZ delay. JP105: short to clear a fault. D102: holds SDZ near PVCC or below.
SPK_MUTE high (R107): muted. Q2 (sheet 1) pulls it low to play. R108, C124: mute ramp. D103: holds MUTE near PVCC or below.
AMP_FAULTZ ≈ 3.2 V: no fault. Low: speaker fault, latched. To Daisy pin 32 (sheet 1).
ORDERED PARTS NOT ON THE BOARD
X101, X102: sockets for the Daisy (A1). X103, X104: the DFR0571 input cable (J106). X105-X108: shunts for JP101-JP104. X109: panel switch, wired to SW101.

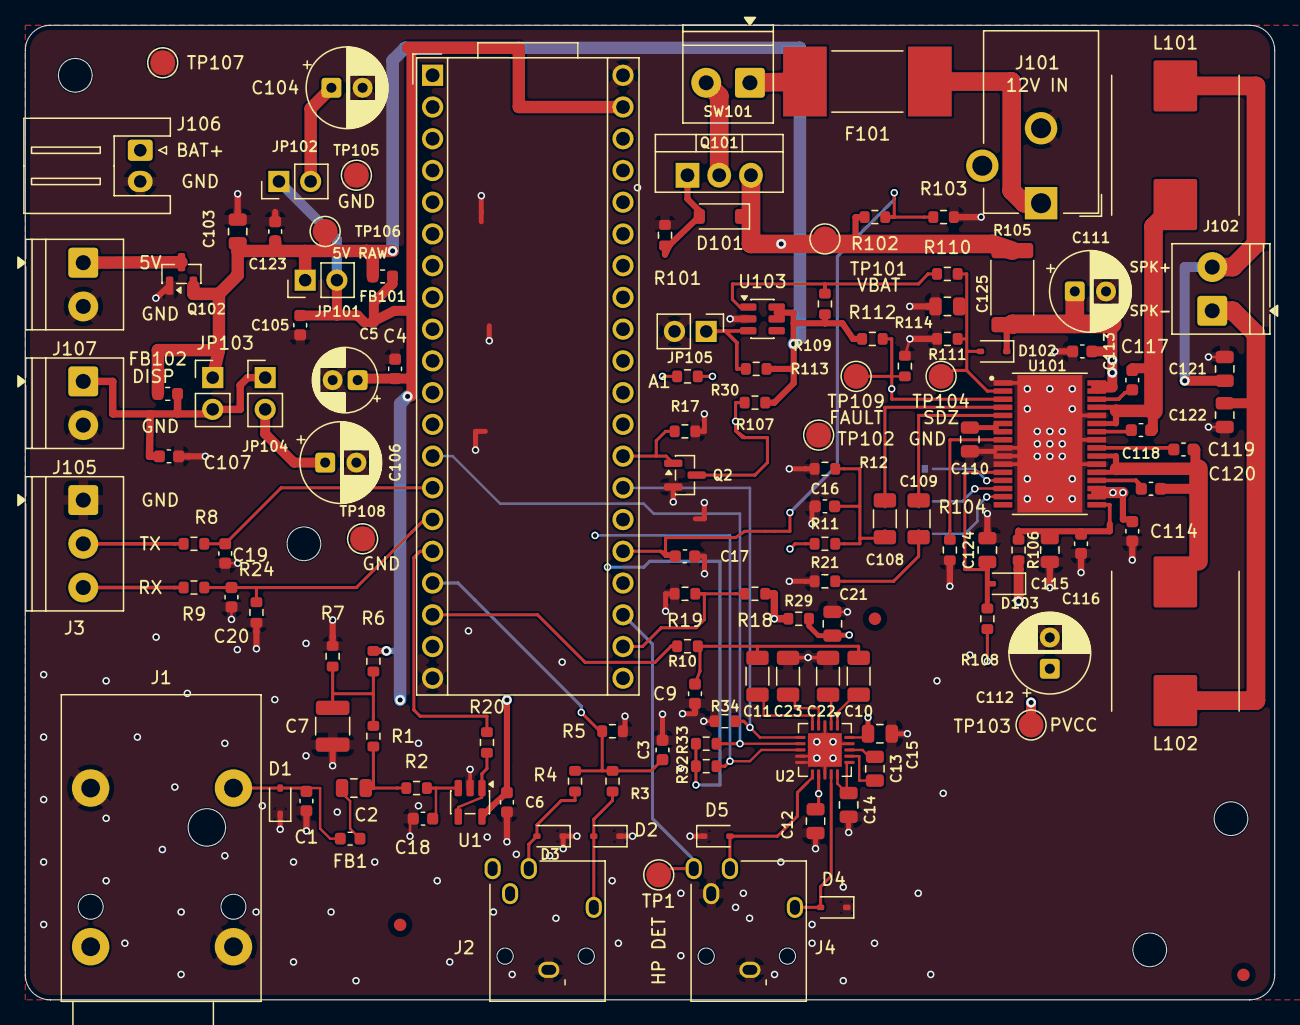
[picture p11: board amp-board.kicad_pcb from above]

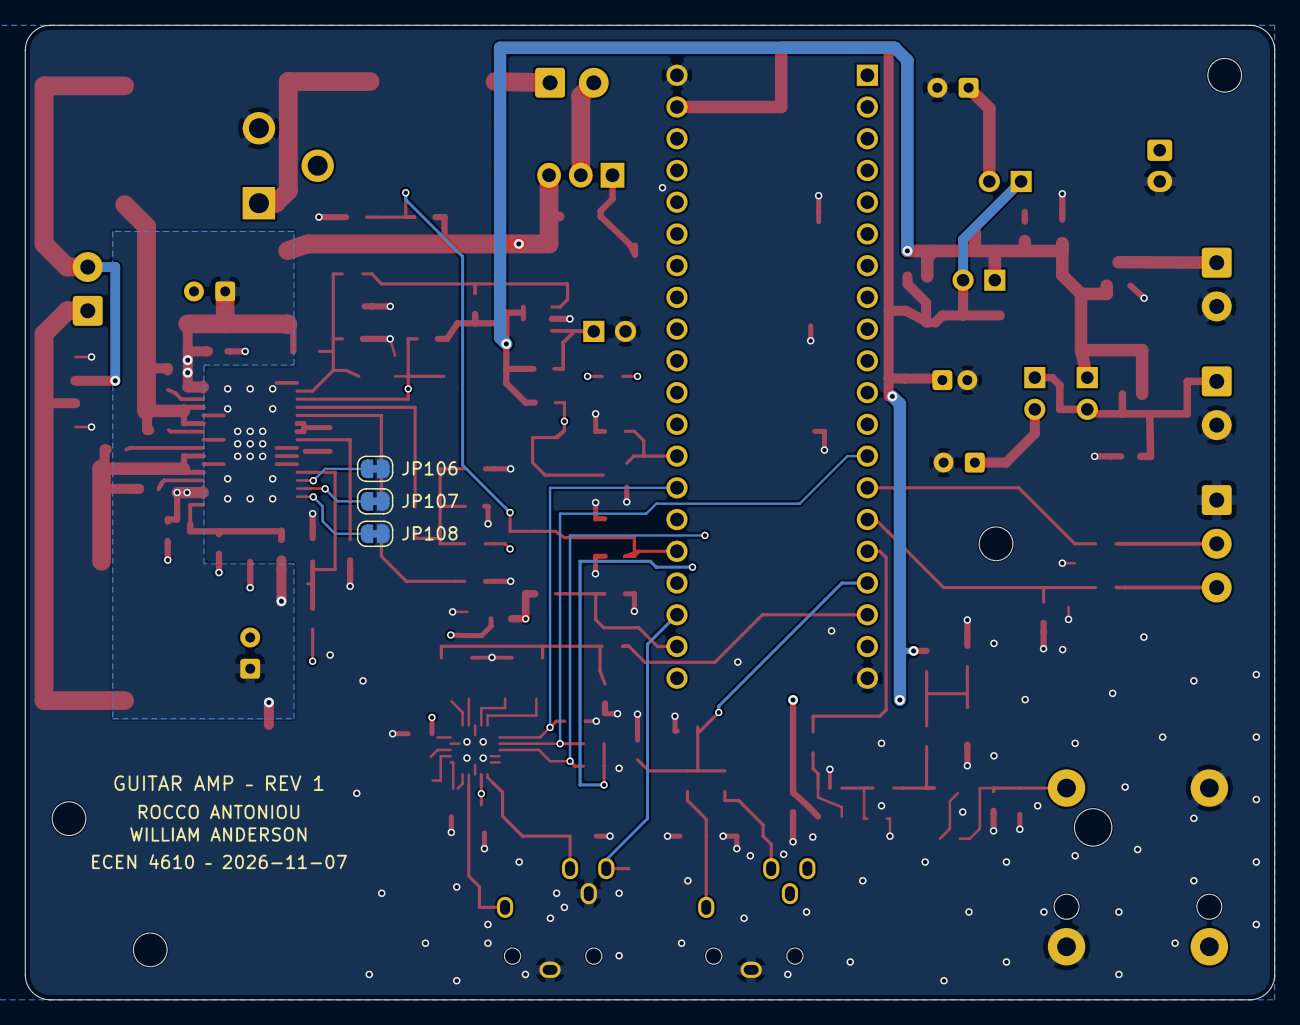
[picture p12: board amp-board.kicad_pcb from below]

Board: 4 copper layers, 100.0 x 78.0 mm, 139 parts (3 on the bottom side), 73 nets.

Other parts of the board:
FID1, FID2, FID3: Fiducial; Fiducial_1mm_Mask2mm
H1, H2, H3, H4: MountingHole_2.7mm_M2.5
