B1narySolutions/amp-hardware/power-board/Rev1_Power_Board.kicad_pcb

## KiCad design power-board/Rev1_Power_Board.kicad_pcb (2026-11-05)

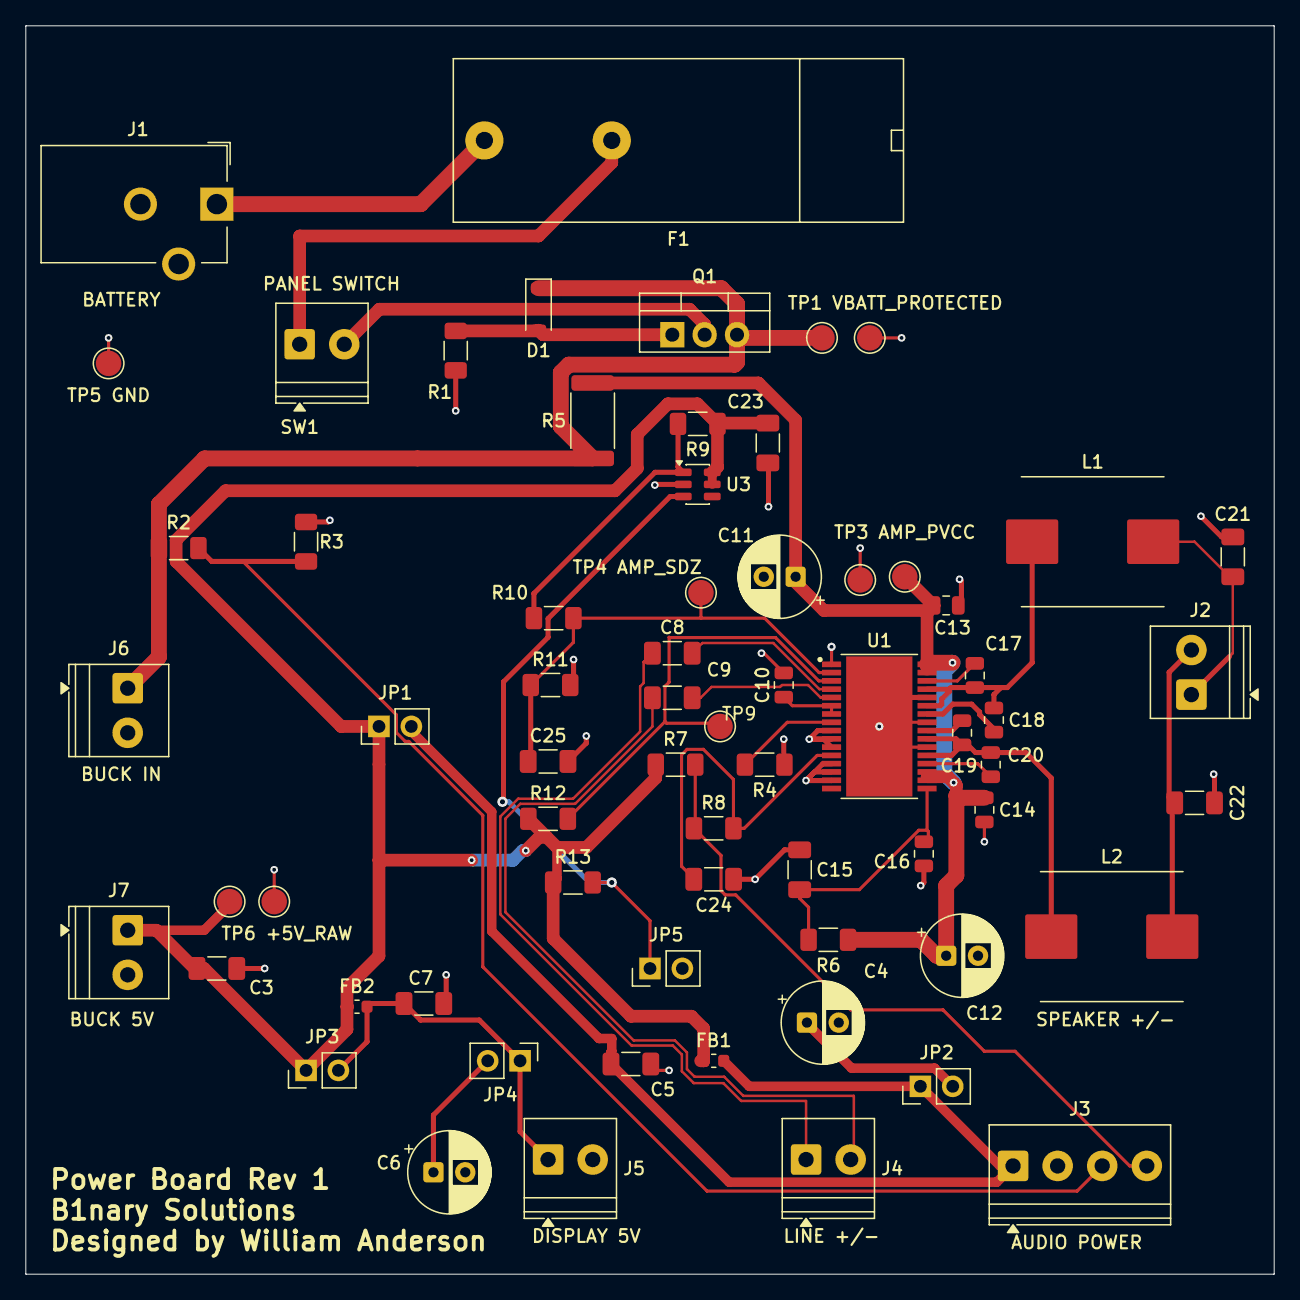
[picture p13: board Rev1_Power_Board.kicad_pcb from above]

Board: 2 copper layers, 98.0 x 98.0 mm, 67 parts (0 on the bottom side), 34 nets.

Parts:
C3: 10u 10V; C_1206_3216Metric_Pad1.33x1.80mm_HandSolder
C4, C6: 100u 10V; CP_Radial_D6.3mm_P2.50mm
C5, C7, C23: 100n 10V; C_1206_3216Metric_Pad1.33x1.80mm_HandSolder
C8, C9: 1.5u 16V MATCH; C_1206_3216Metric_Pad1.33x1.80mm_HandSolder
C10: 1u 16V; C_0805_2012Metric
C11, C12: 100u 25V; CP_Radial_D6.3mm_P2.50mm
C13, C14: 100n 50V; C_0805_2012Metric
C15: 1u 25V; C_1206_3216Metric_Pad1.33x1.80mm_HandSolder
C16: 100n 25V; C_0805_2012Metric
C17, C18, C19, C20: 220n 25V; C_0805_2012Metric
C21, C22: 680n 50V X7R; C_1206_3216Metric_Pad1.33x1.80mm_HandSolder
C24, C25: 1u 10V; C_1206_3216Metric_Pad1.33x1.80mm_HandSolder
D1: BZT52C12; D_SOD-123
F1: T3.15A; Fuseholder_Bulgin_FX0457_P10.00mm
FB1, FB2: MPZ1608S221ATA00; L_0603_1608Metric
J1: PJ-102AH; BarrelJack_CUI_PJ-102AH_Horizontal
J2: 4 ohm SPEAKER BTL; TerminalBlock_Phoenix_PT-1,5-2-3.5-H_1x02_P3.50mm_Horizontal
J3: TO AUDIO CARRIER J6; TerminalBlock_Phoenix_PT-1,5-4-3.5-H_1x04_P3.50mm_Horizontal
J4: FROM CARRIER J5; TerminalBlock_Phoenix_PT-1,5-2-3.5-H_1x02_P3.50mm_Horizontal
J5: DISPLAY USB POWER CABLE; TerminalBlock_Phoenix_PT-1,5-2-3.5-H_1x02_P3.50mm_Horizontal
J6: TO DFR VIN / GND; TerminalBlock_Phoenix_PT-1,5-2-3.5-H_1x02_P3.50mm_Horizontal
J7: FROM DFR 5V / GND; TerminalBlock_Phoenix_PT-1,5-2-3.5-H_1x02_P3.50mm_Horizontal
JP1, JP3: BEAD BYPASS: shunt = direct; PinHeader_1x02_P2.54mm_Vertical
JP2, JP4: OPTIONAL BULK ENABLE; PinHeader_1x02_P2.54mm_Vertical
JP5: RESET / MANUAL FAULT CLEAR; PinHeader_1x02_P2.54mm_Vertical
L1, L2: SRP1038A-100M 10uH; L_Bourns_SRP1038A_LeadFrame
Q1: IRF4905; TO-220-3_Vertical
R1, R7, R9, R12, R13: 10k; R_1206_3216Metric_Pad1.30x1.75mm_HandSolder
R2: 30k 1%; R_1206_3216Metric_Pad1.30x1.75mm_HandSolder
R3: 10k 1%; R_1206_3216Metric_Pad1.30x1.75mm_HandSolder
R4: 5.6k 1%; R_1206_3216Metric_Pad1.30x1.75mm_HandSolder
R5: 0R AMP ISOLATION; R_2512_6332Metric
R6: 10R; R_1206_3216Metric_Pad1.30x1.75mm_HandSolder
R8, R10: 2.2k; R_1206_3216Metric_Pad1.30x1.75mm_HandSolder
R11: 100k; R_1206_3216Metric_Pad1.30x1.75mm_HandSolder
SW1: PANEL SPST - TERMINAL INTERFACE; TerminalBlock_Phoenix_PT-1,5-2-3.5-H_1x02_P3.50mm_Horizontal
TP1 VBATT_PROTECTED: VBAT_PROTECTED; TestPoint_Pad_D2.0mm
TP2, TP5 GND, TP7, TP8: GND; TestPoint_Pad_D2.0mm
TP3: AMP_PVCC; TestPoint_Pad_D2.0mm
TP4: AMP_SDZ; TestPoint_Pad_D2.0mm
TP6: +5V_RAW; TestPoint_Pad_D2.0mm
TP9: AMP_FAULTZ; TestPoint_Pad_D2.0mm
U1: TPA3118D2DAPR; TI_DAP0032C_HTSSOP32_P0.65mm_EP3.04x3.74mm
U3: TPS3808EG50DBVR; SOT-23-6

Connections:
/+5V_AUDIO: C5.1, FB1.2, J3.1, JP1.2 (B), JP2.1 (A)
/+5V_DISPLAY: C7.1, FB2.2, J5.1, JP3.2 (B), JP4.1 (A)
/+5V_RAW: C3.1, C23.1, FB1.1, FB2.1, J7.1, JP1.1 (A), JP3.1 (A), R7.1, R9.1, R12.1, R13.1, TP6.1 (1_1), U3.5 (SENSE), U3.6 (VDD)
/AMP_AVCC: C15.1, C16.1, R6.2, U1.17 (AVCC)
/AMP_FAULTZ: R12.2, TP9.1, U1.3 (FAULTZ)
/AMP_GAIN: R4.1, U1.8 (GAIN/SLV)
/AMP_INN: C9.2, U1.5 (RINN)
/AMP_INP: C8.2, U1.4 (RINP)
/AMP_MR: JP5.1 (A), R13.2, U3.3 (MR_N)
/AMP_MUTE: C24.1, R8.2, U1.12 (MUTE)
/AMP_PG: R9.2, R10.1, U3.1 (RESET_N)
/AMP_PVCC: C11.1, C12.1, C13.1, C14.1, R5.2, R6.1, TP3.1 (1_1), U1.18 (PVCC), U1.19 (PVCC), U1.31 (PVCC), U1.32 (PVCC)
/AMP_SDZ: C25.1, R10.2, R11.1, TP4.1 (1_1), U1.2 (SDZ)
/BAT_MON: J3.3, R2.2, R3.1
/BSNL: C20.1, U1.20 (BSNL)
/BSNR: C18.1, U1.26 (BSNR)
/BSPL: C19.1, U1.24 (BSPL)
/BSPR: C17.1, U1.30 (BSPR)
/CAP_BANK_A: C4.1, JP2.2 (B)
/CAP_BANK_D: C6.1, JP4.2 (B)
/GVDD: C10.1, U1.6 (PLIMIT), U1.7 (GVDD)
/Line+: C8.1, J4.1
/Line-: C9.1, J4.2
/OUT_N: C19.2, C20.2, L2.1, U1.21 (OUTNL), U1.23 (OUTPL)
/OUT_P: C17.2, C18.2, L1.1, U1.27 (OUTNR), U1.29 (OUTPR)
/SPK+: C21.1, J2.1, L1.2
/SPK-: C22.1, J2.2, L2.2
/SPK_MUTE: J3.4, R7.2, R8.1
/VBAT_PROTECTED: D1.1 (K), J6.1, Q1.3 (S), R2.1, R5.1, TP1 VBATT_PROTECTED.1 (1_1)
GND: C3.2, C4.2, C5.2, C6.2, C7.2, C10.2, C11.2, C12.2, C13.2, C14.2, C15.2, C16.2, C21.2, C22.2, C23.2, C24.2, C25.2, J1.2, J3.2, J5.2, J6.2, J7.2, JP5.2 (B), R1.2, R3.2, R4.2, R11.2, TP2.1 (1_1), TP5 GND.1 (1_1), TP7.1 (1_1), TP8.1 (1_1), U1.1 (MODSEL), U1.9 (GND), U1.10 (LINP), U1.11 (LINN), U1.13 (AM2), U1.14 (AM1), U1.15 (AM0), U1.22 (GND), U1.25 (GND), U1.28 (GND), U1.33 (PowerPAD), U3.2 (GND)
unnamed: D1.2 (A), Q1.1 (G), R1.1
unnamed: F1.1, J1.1
unnamed: Q1.2 (D), SW1.2 (B)
unnamed: F1.2, SW1.1 (A)
