B1narySolutions/amp-hardware/(commit log)

2026-10-25 Add audio board rev 2 from seed3-carrier-board
2026-10-25 Rev 2 schematic: remove encoder, set revision 2.0
    Remove the master volume encoder (SW1, R18-R23, C19-C21). Volume moves
    to the touchscreen/ESP32 side. Daisy pins 22-24 are now spare and go
    only to the J7 breakout as A0-A2. Set the schematic revision to 2.0 and
    update CHANGES.md to match. ERC: 0 violations.
2026-10-25 Rev 2: replace U3 watchdog with STM32 IWDG
    Remove U3 (SN74LVC1G123), R24, R25, C22, C23 and Q3. Daisy pin 33
    (HP_EN, was AUDIO_ALIVE) drives U2 EN directly with R26 pull-down,
    and Q4 alone drives SPK_MUTE from SPK_EN. Firmware feeds the internal
    watchdog only from the audio callback; on reset the pins float and
    the pull-downs mute both amps. TP10 renamed TP_HP_EN.
2026-10-25 Add pop, hiss and mute tests; delay speaker enable at power-on
    TEST_PLAN.md gains Stage 7 (rev 2): power-on/off pops, SPK_EN delay,
    headphone plug-in ramp, watchdog mute timing, EarPods hiss and max
    headphone level. CHANGES.md firmware list now waits ~0.5 s after audio
    starts before raising SPK_EN.
2026-10-25 Update audio board test plan for rev 2
    Rewrite the circuit summary, pinouts, equipment, stages 0-6, fault-finding
    hints and results log against the rev 2 schematic netlist: TLV9064 quad,
    TPA6132A2 DirectPath amp with HP_EN, 8-pin J3 power-board signals, J8 line
    out, J9 AUX input, J5 headphone detect, Q4 speaker mute, FB1/C30 display
    supply. Add new stages 3C (speaker send) and 3D (AUX input). Include the
    rev 2 Stage 7 (pops, hiss and mute) unchanged.
2026-10-25 Add power-board directory with README
2026-10-25 Start rev 2 layout: outline, stackup, IC and connector placement
    New seed3-carrier.kicad_pcb, generated from the rev 2 schematic netlist:
    - 90 x 80 mm outline, 2 mm corner radius, four M3 NPTH mounting holes
    - JLC04161H-7628 4-layer 1.6 mm stackup; L2 and L3 are solid GND zones
    - Jacks on the front edge (J1, J9, J5, J2), Daisy with USB at the rear,
    J6/J7 breakouts aligned pin-for-pin, U1/U2 near the audio pins and J5,
    J3/J4 together at the rear right, J8 above J2
    - Passives, Q1, Q4, FB1 and test points parked off-board for placement
    DRC: 0 schematic parity issues. Open: U2 thermal vias (0.2 mm drill)
    are below the 0.3 mm minimum hole rule. CHANGES.md records the
    placement reasoning and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
2026-10-25 Use 0.3 mm vias under U2 and set board design rules
    U2 footprint:
    - Switch to WQFN-16-1EP_3x3mm_P0.5mm_EP1.6x1.6mm (no thermal vias) in the
    schematic and symbol library; the _ThermalVias variant drills 0.2 mm,
    below the 0.3 mm minimum hole
    - Add four 0.6/0.3 mm GND vias in the exposed pad on the board
    Design rules:
    - Minimum track width 0.3 -> 0.2 mm (matched the Default class, which
    failed DRC), minimum annular ring 0.1 -> 0.15 mm
    - New Power net class (1 mm track, 0.8/0.4 via) for +5V, 5V_IN,
    DISPLAY_5V, 3V3_A and 3V3_D; track and via presets
    - seed3-carrier.kicad_dru adds per-class min/opt/max for track width and
    via size
    DRC: no violations beyond unrouted nets and front-edge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
2026-10-25 Place passives on the rev 2 carrier board
    - Analog section between the Daisy and the front jacks, grouped by
    signal path. The guitar input is one short row from the J1 tip to U1
    pin 3 that can be routed on L1 with no vias
    - U1 rotated so pins 1-7 face the jacks and pins 8-14 face the Daisy;
    moved down 1 mm to make room above it
    - AUX front end as a block left of J6; R39/R42 at U1 pin 12
    - U2 rotated: inputs toward C12/C13, charge pump away from J5,
    decoupling within 3 mm of its pins
    - Power entry, power board controls and display parts in the rear
    right; J4 moved down 8 mm, J8 closer to J2
    - 0.8 mm passive references placed clear of pads and parts; C12/C13
    MPN fields hidden on th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
2026-10-26 Shrink carrier board to 90 x 62 mm with the Daisy along the rear edge
    - Daisy rotated 90 degrees and laid flat along the rear edge, USB on the
    left; audio pins 16-19 face U1. J6/J7 still line up pin-for-pin
    - Front jacks and the analog cluster moved back 18 mm unchanged
    - AUX front end above J1; power entry, power board controls and display
    parts in the rear-right corner beside the Daisy
    - Three M3 holes (rear right, and one each side behind the 1/4" jacks);
    the fourth had no room
    - Silkscreen labels re-placed
    DRC: only unrouted nets and front-edge jack silkscreen; 0 schematic
    parity issues. CHANGES.md updated for the new outline and placement.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
2026-10-26 Spread tight part clusters on the carrier board
    Different-net neighbours with under 1 mm of copper between pads went from
    24 pairs to 7, for easier hand soldering and room for a 0.2 mm trace
    between blocks. The remaining 7 are deliberate: decoupling and
    pin-adjacent parts at U1/U2, and R31 at J5.
    - Speaker filter row moved up under J6; C24 below R28 with a gap
    - HP filter, VREF divider and front test points re-spaced below U1
    - C12/C13 apart; control block on a 2.9 mm pitch; C30 and R26 upright
    - Labels re-placed
    parity issues. Board size unchanged at 90 x 62 mm.
    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
2026-10-26 Use thermal reliefs on through-hole pads for iron soldering
    - L2/L3 GND zones set to "Thermal reliefs for PTH": four 0.5 mm spokes,
    0.5 mm gap. SMD pads and vias (including U2's exposed-pad vias) stay
    solid
    - New rule in seed3-carrier.kicad_dru enforces thermal reliefs on
    through-hole pads for any zone, so later zones can't undo it
    - Zones refilled; DRC shows no starved thermals (min 2 spokes)
    The through-hole parts are hand-soldered with an iron. Jack sleeves and
    GND pins tied solidly into two planes would not heat enough.
2026-10-26 Add LCSC part numbers to the carrier board BOM
    - Hidden LCSC field on every schematic symbol except the Neutrik
    jacks (not stocked at LCSC); copied to the board footprints so
    schematic parity stays clean
    - Parts chosen from JLC's library on 2026-10-25: 11 basic and 11
    extended SMD lines for JLC assembly, plus LCSC numbers for the
    hand-soldered through-hole parts
    - C0G kept for the RC filter caps; 3 A ferrite bead for the display
    feed; C7, C18 and C9/C26 use higher-voltage parts in the same
    footprints
    - CHANGES.md: parts table with stock, and an open item for U2
    (TPA6132A2RTER, only 65 at JLC)
    ERC clean; DRC shows only unrouted nets and front-edge jack
    silkscreen; 0 schematic p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
2026-10-26 Let power traces neck down at U1 and U2
    The Power class routed at 1 mm everywhere, too wide to land on U2's
    0.25 mm pads (0.5 mm pitch) or U1 pin 4 without touching the next pin.
    - Inside U2's courtyard, Power tracks default to 0.25 mm (min 0.2 mm);
    inside U1's, 0.5 mm (min 0.3 mm). Placed after "Power track width"
    so they take precedence
    - Power minimum elsewhere raised from 0.3 mm to 0.5 mm
    - 0.25 mm track width preset added
    - Tested with sample traces: neck-downs pass with no clearance errors,
    a 0.25 mm power trace in open board space is flagged
2026-10-26 Remove J6/J7 breakouts and shrink board to 90 x 56.5 mm
    Schematic:
    - J6/J7 (1x20 sockets mirroring the Daisy), their 40 labels and the
    breakout heading removed
    - The 24 Daisy pins that only went to them (D0-D12, A0-A2, A7-A11,
    USB D+/D-, 3V3_A) marked no-connect; ERC clean
    Board:
    - J6/J7 footprints removed; Daisy pads synced to the new nets
    - Daisy moved 5.4 mm into J7's strip; jacks and analog section moved
    5.5 mm with it. 90 x 62 -> 90 x 56.5 mm
    - Display group repacked beside J4 on the right edge; spacing (>= 1 mm
    between different-net pads) kept apart from the deliberate U1/U2 cases
    - Zones refilled, labels re-placed
    Docs:
    - TEST_PLAN.md probes the Daisy sockets (A1.n) with the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
2026-10-26 Remove TP5/TP9/TP10, C9 and the U1B headphone buffer
    TP5, TP9 and TP10 duplicated pads that are easy to probe (C7, C18,
    R26), and C9 sat on the same node as C18 and C17. The test plan now
    probes those parts instead.
    The Seed3's AC-coupled 1 Vrms outputs can drive U2's ~9.9 kOhm input
    load through R2, as Electrosmith's own reference circuits do, so C5 and
    R6 are gone. HP_SOURCE is now the R2/C2 node, and U1B is parked as a
    VREF follower. Full scale reaches U2 at about 0.75 Vrms, below its
    clip point.
2026-10-26 Remove R5, R42, R30, R31, C27 and R36
    R5 paralleled R17's bias path and only lowered the guitar input load.
    R42 added nothing after the AUX path's 5k of series resistance.
    HP_DETECT and PWR_BTN now use the STM32's internal pull-ups, as the
    Seed3 datasheet's own switch circuits do. J5's isolated, on-board
    detect switch needs no series resistor or RC either. Daisy pin 38
    (3V3_D) is now unused.
    C17 stays: with C9 gone it is the only ceramic at the power entry.
2026-10-26 Split rev 2 notes into CHANGES.md and DESIGN.md
    CHANGES.md had become a change log, a description of the current
    design and a sourcing guide at once, with history layered through it.
    DESIGN.md now describes the board as it stands, with every rationale,
    the J3 pinout, firmware requirements, open items, layout and sourcing.
    CHANGES.md keeps only the net difference from rev 1 and the list of
    unused reference designators. Dropped: added-then-removed history and
    style notes.
2026-10-26 Update schematic notes after the headphone buffer removal
    Rename the HEADPHONE BUFFER heading to HEADPHONE FILTER and note that
    U1B is parked as a VREF follower. The headphone detect note now says
    HP_DETECT relies on PG9's internal pull-up, so it floats until the
    firmware runs.
2026-10-26 Remove the studies folder
    The signal-path study modelled the rev 1 circuit (RV1, R5, the U1B
    buffer and the old headphone amp) and pointed at a rev1/ folder and
    J6 breakout that aren't in this repo. Drop the folder and the two
    citations of it in CHANGES.md and DESIGN.md.
2026-10-26 Fix stale heading, A1 value and 3D models
    - Rename the schematic's CONTROLS & DISPLAY heading to DISPLAY; the
    encoder it covered is gone.
    - A1's value is now "Daisy Seed3" instead of the Rev 4 symbol name, so
    the BOM names the right module.
    - A1, J1 and J2 pointed at KiCad 3D models that don't exist. A1 now
    uses the repo's Daisy placeholder on two 8.5 mm 1x20 socket models,
    and J1/J2 use the Neutrik placeholder.
    - Remove the unused PTV09A pot footprint and the pot and SJ1-3535NG
    placeholders, along with their code in make_placeholders.py.
2026-10-26 Add a 3D placeholder for the SJ3-35063AG jacks
    J5 and J9 had no 3D model. The placeholder follows the datasheet:
    an 11 x 9 x 4.5 mm body behind a 3 mm, 6 mm diameter nose, with the
    axis 2.25 mm above the PCB. The model is set in the project footprint,
    so footprint updates keep it, and on the two board copies.
2026-10-26 Isolate HP_EN from U2 and fix the AUX and line-out levels
    The Daisy can run from USB while the carrier's +5V is off. HP_EN then
    drove U2's EN pin above its VDD + 0.3 V rating. U4 (TXU0101) now sits
    between HP_EN and EN, powered from the Daisy's 3V3_D and +5V. Its
    output goes high-impedance when either supply is off, and R26 holds
    EN low.
    - R38 47k -> 4.7k: with the same signal on both AUX channels, 2 Vrms
    reached the Daisy at 4.9 Vpp, over its 3.6 Vpp range. Now 2.7 Vpp.
    - R43 1k -> 10k: limits current into an unpowered display. Caps the
    display UART at 230400 baud.
    - Speaker enable delay raised from 0.5 s to 4 s after power-on, so the
    line-out bias settles before the speaker amp unmu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
2026-10-26 Remove the line-out buffer and return U1 to a TLV9062
    The Seed3's outputs are AC-coupled and can drive a cable directly, so
    R28/C24 now feed LINE_OUT without U1C, C25, R29, C26 or R3. That also
    removes the power-on drift and the 4 s speaker-enable delay. With U1C
    and the parked unit gone, U1 is a TLV9062 dual and the AUX buffer is
    U1B. J2 stays live with headphones in, for recording while monitoring.
2026-10-26 Place the SOIC-8 U1, C8 and the line-out filter
    U1 takes the old SOIC-14 spot with pin 3 next to R1 and both outputs
    heading straight to Daisy pins 16 and 17. C8 sits above pin 8. R28/C24
    move beside J8 so the long run from the Daisy carries the low-impedance
    DAC output. Includes the Update PCB from Schematic sync for U1's new
    footprint and the removed line-out buffer parts.
2026-10-26 Correct the Seed3 output claims and add an output DC check
    The Seed3 datasheet doesn't say the outputs drive 16 ohm headphones or
    are AC-coupled. The TAC5242 drives headphones only in its differential
    modes; the module's single-ended outputs match its line-out-only mode
    (600 ohm minimum load). Note that the codec powers down its DAC when
    its clocks stop, fix the C8 pin number, and add TEST_PLAN 5.16 to
    measure DC at pins 18/19 and LINE_OUT with the Daisy fitted.
2026-10-26 Feed the AUX input straight to the Daisy and use a single op-amp
    The Seed3's inputs are AC-coupled and the TAC5242 presents about 5k,
    so the R40/R41 sum can drive Daisy pin 17 directly. This drops U1B,
    C32 and R39, and R38 becomes a 100k DC return. U1 is now a TLV9061 in
    SOT-23-5, with a two-unit project symbol, re-placed at the end of the
    guitar row with C8 beside its V+ pin. TEST_PLAN 5.17 checks the AUX
    level with the Daisy fitted.
2026-10-26 Remove U4, C37, C38 and R26 and tie U2 EN to +5V
    The codec already powers down its DAC when an IWDG reset stops its
    clocks, which silences the headphones as well as J2. Driving U2's EN
    from the Daisy needed a level translator because the Daisy can run
    from USB with +5V off, so drop it and leave U2 always on.
2026-10-26 Add a +5V sense on Daisy pin 22 to keep USB-only audio out of U2
    With the Daisy on USB and +5V off, U2's charge pump rails sit at 0 V,
    so its inputs are rated only to about +-0.3 V, while C12/C13 pass pin
    18's full-scale +-1.4 V. R45/R46 (100k/100k) put +5V/2 on 5V_SENSE
    (ADC_0) so the firmware can hold the outputs silent while +5V is down.
    DESIGN.md sets the firmware thresholds and settle time and notes the
    fast-power-loss limit; TEST_PLAN 5.18 scopes the transitions.
2026-10-26 Re-lay out the carrier schematic into framed functional sections
    Group the sheet into eleven dashed, titled sections laid out left to
    right (inputs and supply, Daisy and display, outputs, power board and
    mute), moving each block rigidly so no connection changes. Misplaced
    parts move to their own blocks: the AUX input, C17/C18, FB1/C30, J2/J8.
    Rewrite every note in one style inside its section, correct the stale
    HP_DETECT/SPK_EN note, and add notes for the AUX input, VREF, display
    resistors and Daisy sockets. Update the title block, set J1/J2 to
    NRJ4HF and C7/C18 to the 16 V parts on the BOM (board values match).
2026-10-26 Re-annotate the carrier board in sheet order
    Renumber R, C, J, Q and TP left to right, then top to bottom by
    section, so the designators have no gaps: R1-R19, C1-C18, J1-J7,
    Q1-Q2, TP1. U1, U2, A1 and FB1 keep their numbers, so the U1/U2
    design rules are unchanged.
    Apply one mapping to the schematic, the board, the sheet notes and
    DESIGN.md/TEST_PLAN.md, and rename the five auto-generated board nets
    that embed a designator. CHANGES.md names removed parts by their rev 1
    designator and lists every old number against its new one.
    Netlists before and after match net for net once the old one is
    translated through the mapping; ERC and schematic parity are clean.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
2026-10-26 Set R5 to 3.3k and run U2 at -6 dB
    R5 at 100k left the AUX level to the Daisy's unpublished input
    impedance: with no module load a 2 Vrms source would reach ~5.4 Vpp,
    past the pin's absolute maximum. At 3.3k, R3||R4 into R5 alone caps it
    at 2.25 Vpp, and the expected level is 1.5-1.7 Vpp.
    At 0 dB, full scale (~0.75 Vrms) clips U2 into 16 ohm headphones: its
    1% THD limit there is 25 mW (~0.63 Vrms). Tying G0 to GND gives -6 dB
    and ~0.40 Vrms full scale, with 4-6 dB of margin at 16-32 ohm.
    DESIGN.md, CHANGES.md, TEST_PLAN.md and the sheet notes carry the new
    levels and corners.
2026-10-26 Correct stale and wrong statements in the design docs
    An audit of DESIGN.md, TEST_PLAN.md and CHANGES.md against the
    schematic, board and netlist found these:
    - TEST_PLAN 1.10 expected 1 MOhm from J1 tip to GND; C1 and C2 block
    DC, so it reads open.
    - TEST_PLAN 1.4 expected ~5 kOhm on VREF; it is 5-10 kOhm.
    - TEST_PLAN 1.1 named U2.6 as a +5V short; G0 is GND now, so the risk
    is U2.14 (VDD) bridged to U2.15 (SGND).
    - TEST_PLAN 3C.2 and DESIGN line-out level: 0.73 Vpp / -2.7 dB with
    R12 counted. Add the 16 ohm load that 7.8 needs to the equipment.
    - DESIGN: drop J4's nonexistent TN/RN pins, correct R15's position
    and the Daisy pins the power-board nets reach (25-28, not 33/34),
    lis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
2026-10-26 Add a pad after the guitar buffer for active pickups
    U1 at unity gain could swing ~4.8 Vpp into AUDIO_IN_1, past the Daisy
    pin's 3.6 Vpp full scale and +-1.8 V absolute maximum. R20 (470 ohm,
    C4502) into R21 (1k to GND, C4410) scales U1's swing so the pin never
    sees more than 3.4 Vpp, even with no module load and U1 at both rails.
    The input is now clean to ~4.8 Vpp at J1, which covers passive and
    typical 9 V active pickups; hotter sources clip harmlessly in U1.
    Passive pickups lose 3.9 dB of converter signal-to-noise. R20/R21 sit
    above U1 pin 1 on the board.
    DESIGN.md, TEST_PLAN.md (new 1.21b and 5.19), CHANGES.md and the sheet
    note are updated. One more extended part (C4502).
    Co-Authored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
2026-10-26 Lower the line-out impedance: R11 to 1k, C16 to 3.3 nF
    R11 is the line out's output impedance. At 3.3k it cost 2.7 dB into a
    10k input and more into lower-impedance gear. At 1k it costs 0.9 dB,
    and a shorted J5 still leaves the Daisy at 1k, above its 600 ohm
    minimum load. C16 goes to 3.3 nF to keep the 48 kHz corner.
    R11 reuses the basic 1k (C4410). JLC had no 3.3 nF C0G 1206 in stock,
    so C16 is the 0805 FH 0805CG332J500NT (C486355, extended), placed
    where the 1206 was. DESIGN.md, TEST_PLAN.md, CHANGES.md and the sheet
    note carry the new values.
2026-10-26 Add a 0 ohm jumper in the line out as a DC-block option
    The line out has no coupling cap and assumes Daisy pin 19 sits at 0 V
    DC, which TEST_PLAN 5.16 has yet to confirm. R22 (0 ohm, C17888, basic)
    now sits between the R11/C16 filter and LINE_OUT. If the pin carries
    DC, R22 is swapped for a 10 uF 1206 ceramic without a respin; R12 then
    holds LINE_OUT at 0 V and the corner with a 10k load is ~1.8 Hz.
    R22 sits below R11, left of R12, on the board. DESIGN.md, TEST_PLAN.md,
    CHANGES.md and the sheet note point at R22 instead of "fit a cap".
2026-10-26 Add ESD diodes on every jack signal contact
    D1-D6 (Nexperia PESD5V0S1BA, SOD-323, C19224) clamp J1 tip, J2
    tip/ring, J4 tip/ring and J5 tip to GND, each placed beside its jack.
    Bidirectional with a 5 V working voltage, so no audio signal on these
    contacts reaches it; 5 nA leakage and 35 pF don't load the 1 MOhm
    guitar input. The isolated J2/J4 detect switches need none.
    The sheet gains a JACK ESD PROTECTION section, with the power-board
    block shifted left to make room, and the J1/J2 nets are named
    GTR_TIP, AUX_TIP and AUX_RING. DESIGN.md also records that the J2/J4
    footprint matches the Same Sky datasheet layout; TEST_PLAN adds 1.21c.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
2026-10-27 Drop the 1/4" line out, the input pad, R22 and D6
    The speaker send now goes only to the internal header (J5, was J6), and the
    power board connector is J6 (was J7). R20 stays as a 470 ohm series resistor
    with no pad, since active pickups are out of scope. Docs and test plan follow.
2026-10-27 Re-place the carrier passives and route the analog section
    Each filter and divider now sits at its load, so long runs are the
    low-impedance ones: the AUX sum moves under Daisy pin 17 (J2 moves right
    so its lines no longer cross the guitar row), R10/C9 join U2's input caps,
    and the VREF divider sits at R1. U2 is rotated 180 degrees so OUTL and SGND
    run side by side on L1 to J4's tip and sleeve; OUTR takes one via to L4.
    J5 moves into the power corner so the power board's ground loop through
    J5/J6 stays away from U1 and U2.
    Every SMD GND pad gets its own via. The guitar row, AUX and headphone
    paths, speaker send, U1/U2 decoupling, power entry and an analog-only +5V
    branch on L4 are routed. HP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
2026-10-27 Add KiCad board view, JLCPCB check and edit tools with Claude skills
    tools/kicad/ holds three command-line tools for the boards in this repo:
    - board_view.py renders a board to PNG with real pad shapes, tracks to
    scale, vias, silkscreen labels and KiCad's own ratsnest, whole or zoomed
    to a window or to parts.
    - board_check.py runs the project's DRC and schematic parity, then checks
    the board against JLCPCB's fabrication limits (errors), its recommended
    and silkscreen legibility values (warnings), and its PCBA rules: body to
    edge 2.5 mm, Economic single side and 0402 minimum, pin pitch, LCSC part
    numbers and open vias in pads. It works on temporary copies and never
    modifies the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
2026-10-27 Move C8 off the board edge and enlarge references to 1.0 mm
    JLC's assembly terms need 2.5 mm between a part body and the board edge,
    and C8 was 1.5 mm from the right edge. FB1 now sits beside J3 pin 4 and
    C8 lies horizontally below them, 3.35 mm from the edge; DISPLAY_5V and
    C8's GND via are re-routed to match.
    References go from 0.8 mm / 0.12 mm to JLC's legibility minimum of
    1.0 mm / 0.15 mm. To fit them, the power board series resistors move
    1.6 mm down from J6 with labels alternating above and below, C18 and
    R8/R9 shift to clear the new labels, and Q1's GND via moves clear of
    Q1's label.
    Checked with tools/kicad/board_check.py: no JLC errors and no text-size
    warnings remain; only the d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
2026-10-27 Resize labels in place and check KiCad's lock file before editing
    Found while using the tools on the rev 2 board:
    - label(ref, height=..., thickness=...) without x/y now resizes a label
    where it is, instead of needing the caller to read its position.
    - A label auto_labels can't place keeps its old position rather than
    being left on the part's centre.
    - The edit skill and README check for ~<board>.kicad_pcb.lck, which the
    PCB editor writes while a board is open. A running KiCad with only the
    schematic open is fine for board edits; pgrep couldn't tell the two apart.
2026-10-27 Use screw terminals for the power board, display and speaker connectors
    J6 becomes a 4-way 3.5 mm screw terminal (5V, GND, BAT, MUTE) and J3 a
    3-way (GND, TX, RX), side by side on the rear edge; J5 becomes a 2-way
    (LINE+, LINE-) on the right edge. All three open toward the board edge and
    have their terminal functions on the silkscreen. KF350-3.5 blocks from
    LCSC; J6 is two 2-ways slid together.
    The power button and PWR_HOLD move to the power board, so R14-R16 and C18
    go and Daisy pins 26/27 become no-connects. The display is powered from the
    power board, so FB1, C8 and DISPLAY_5V go. LINE- is LINE_REF, 1k to GND
    through the new R21, to match R11's source impedance for the speaker amp's
    diff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
2026-10-27 Add footprint, board text and field edits to boardedit
    add_footprint, replace_footprint and remove_footprint take the footprint,
    value, fields, symbol link, pad nets and pin functions from a kicad-cli
    netlist of the schematic next to the board (new schnet.py), as KiCad's
    "Update PCB from Schematic" does. Libraries resolve through the project
    and global fp-lib-tables (kicadenv.footprint_lib_dir). Removing or
    replacing a footprint also removes the track chains on its old pads and
    any via they leave orphaned.
    Also adds text/move_text/remove_text for free silkscreen text (counted as
    an obstacle by auto_labels), set_field, and set_pad_unconnected, which
    names the net the way the schematic does.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
2026-10-27 Align the jack noses and rework mounting holes; add fiducials
    J1 moves 5.9 mm back so its nose tip ends on the same line as J2's and
    J4's. The guitar input row, U1 and the VREF block move with it, and the
    analog +5V branch on L4 is re-routed to C6 and R6.
    Mounting holes become three M2.5: H2 rear-right and H3 front-right, 4 mm
    in from the edges, and H1 rear-left in the 6.4 mm gap behind J1, where an
    M3's keep-out doesn't fit. J1's nut still holds the front-left corner.
    Three asymmetric 1 mm fiducials go next to the holes for JLC's assembly
    camera. Holes and fiducials are board-only footprints.
2026-10-27 Put J1 back with all jack faces on the board edge
    Aligning the nose tips was wrong: the Neutrik NRJ4HF is rear-mounted, so
    its face has to press on the back of the panel like the SJ3 faces, with
    its 8.9 mm threaded nose through the panel for the nut (Neutrik drawing
    ST-NRJ4HF). J1, the guitar input section and the analog +5V branch go
    back to where they were before 771cb61.
    Kept from 771cb61: three M2.5 mounting holes (H1 back in its original
    spot behind J1, H2 rear-right, H3 front-right) and the three fiducials.
    Both jack footprints were checked against the manufacturers' drawings.
2026-10-28 Add a static circuit check: worst-case bounds against part limits and design claims
    circuit_verify.py checks a schematic against what every part can take, for
    everything a spec says can reach the connectors. For each power state, with
    each port nominal and then each misuse on its own, it bounds every voltage and
    current without a simulator and checks pin limits, protection-diode currents,
    resistor power, capacitor voltage, MOSFET current, output loads, port
    currents and the design's claims. Verdicts are pass (proven), fail (the bound
    is tight) or unproven (the bound goes through a clamp or a clipping amplifier,
    so it may be pessimistic).
    - circuit_spec.py: the spec format (rails, ports, pow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
2026-10-28 Fix the carrier's circuit-check failures: wrong-terminal 5 V and AUX into an off codec
    The first run of tools/kicad/circuit_verify.py on the carrier failed five ways. Each is fixed in the
    circuit, with no waivers:
    - R22 (10k, BATT_SENSE to GND): R13/R22 halve BAT. A 5 V wire on BAT now puts at most 2.65 V on pin 25
    (PA7, a TT_a pin: 4.0 V max, no positive injection), and a full 3.3 V battery reading (1.65 V) stays
    inside the ADC's range.
    - R23 (470 ohm, J6.4 to Q2's drain): a 5 V wire on MUTE with Q2 on now draws 11 mA instead of 0.75-2.5 A
    through a 115 mA part.
    - R24 (100k, DISPLAY_UART_RX to GND): with R9 it divides a 5 V wire on RX to 4.78 V (Seed3 GPIO 0-5 V).
    An unplugged disp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
2026-10-28 Simulate the results the static bounds can't settle
    When a bound goes through a conducting clamp or an amplifier at its rail,
    the static check can only say UNPROVEN. circuit_sim.py now searches for a
    counterexample in ngspice, run through KiCad's own libngspice:
    - The netlist comes from the same elements and part models, cut down to
    the subcircuit that can affect the quantity. Clamps become diodes behind
    an offset source, switches voltage-controlled switches, and op-amps a
    transconductance into R || C (open-loop gain and GBW) with soft rail
    limits.
    - Seeds come from Analysis.worst_input: the bang-bang waveform that
    reaches the L1 bound, the worst tone frequency with every tone pea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
2026-10-28 Collect the carrier's power board requirements in the power board README
    The 5 V supply, the battery-level divider (source impedance at most 10k, switched off with the 5 V
    output), the speaker mute (pull-up of 4.7k or more, low through Q2 and R23), the speaker amp's
    differential input and wiring, the display's own supply, and the wiring rules, each with a pointer to
    the DESIGN.md section and the circuit-check spec behind it. DESIGN.md's J6 list links to it.
2026-10-28 Add fault injection, test-plan readings and a carrier–power board contract
    circuit_faults.py injects assembly faults one at a time: two-pin parts open or
    shorted, resistors a decade off, multi-pin parts missing, and solder bridges
    between nearby pads of different nets read from the .kicad_pcb. Each runs the
    circuit check (nominal values, no simulation) in the spec's fault states and
    is reported as damage, function only or no effect, with the test-plan
    readings that catch it. For each damaging fault nothing catches, it suggests
    an unpowered reading that would. About 30 s for 200 faults on the carrier.
    Test stages: a spec can list the bring-up test plan's DMM checks, resistance
    readings unp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
2026-10-28 Speed up the circuit check and the fault check about tenfold
    Profiling showed almost no time in the numerical work. It went into
    bookkeeping around it:
    - The frequency-response step called a tiny einsum once per tolerance
    corner, per subcircuit, per case (about 380,000 calls), rebuilding its
    frequency grid each time. Each subcircuit now stacks its corners into
    one array: one call per quantity over every corner and frequency, with
    frequency grids built once per band and each quantity's transfer data
    cached for every case that shares the subcircuit.
    - The bound engine regrouped the circuit into linear subcircuits for every
    quantity it bounded (48 million union-find lookups in the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
2026-10-29 Route the carrier's last 18 connections
    The power board signals, display UART and Daisy VIN run in ordered lanes
    on L4 between the Daisy's header rows. TX and RX drop to pins 14/15 on L1
    past the VIN lane, and HP_DETECT hops to L4 under the two audio-out traces.
    Each signal via has a GND return via beside it. The board check finds no
    unrouted connections and no errors.
2026-10-29 Correct the power board README's connections to the carrier
    The carrier connects to the power board through two screw terminals
    (J6 and J5, six wires), not three. J3 is the UART link between the
    Seed3 and the display's ESP32-S3, so it moves out of the connections
    table, and the display's UART requirements leave the power board's
    list. The power board still supplies the display's 5 V.
2026-10-29 Make the carrier 2-layer and hand-solderable with a MAX9722A
    So the board fits a free capstone fab (2 layers, under 100 x 100 mm) and
    every part can be soldered with an iron:
    - U2 is now a MAX9722AEUE+ (TSSOP-16, no exposed pad) in place of the
    TPA6132A2 QFN. R25-R28 (10k 0805) set its gain to -1, for about
    0.6 Vrms full scale. C12-C15 are 1 uF, the datasheet's value. U2 and
    its parts move to the open lower-right corner, outputs straight down
    to J4.
    - The stackup is 2-layer 1.6 mm, with GND pours on both sides joined by
    about 160 stitching vias. Every audio net stays on F.Cu over unbroken
    ground. Where traces cross, the non-audio one hops on B.Cu: the analog
    +5V branch, HP_DET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
2026-10-29 Save the carrier's project file as KiCad 10 writes it
    KiCad dropped the net class's diff_pair_via_gap field when it saved the
    project. No design rule changes.
2026-10-29 Source the carrier's parts from DigiKey
    - Every part in the schematic and on the board now has MPN,
    Manufacturer, DigiKey and Datasheet fields in place of its LCSC
    number. seed3-carrier-digikey.csv is the DigiKey order.
    - DESIGN.md says where the B.Cu hops slot the back pour under audio
    traces and why that doesn't matter. CHANGES.md matches.
    No placement or routing changes.
2026-10-29 Describe the carrier's DigiKey parts in the design docs
    DESIGN.md's parts sourcing section still listed LCSC numbers, JLC stock
    and a JLC assembly path. It now lists each part's DigiKey number and
    MPN from seed3-carrier-digikey.csv.
    - J3, J5 and J6 are Phoenix PT 1,5 blocks, the parts the footprints are
    drawn for, so J6 is one 4-way block instead of two KF350s slid
    together. The "J6 fit" open item goes. The 5 V/GND current note
    (here and in the power board README) uses the PT 1,5 rating.
    - U1 is the TLV9061-Q1 in the same package. C5 is a Würth
    electrolytic, no longer called low-ESR.
    - The 1x20 Daisy headers aren't in the DigiKey CSV yet. The section
    says so.
    - A JLC assembly ord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
2026-10-29 Waive the boost-pedal input check and test the Daisy's audio pins
    The carrier's circuit and fault checks now both pass:
    - Waive A1.in16's absolute maximum under an 18 V boost pedal on J1.
    DESIGN.md "Guitar input" already records the decision: boost pedals
    are out of scope, and R20 limits the pin's protection current to
    about 1-2 mA (the simulation reached 1.27 mA). This failure predates
    the 2-layer redesign.
    - TEST_PLAN 1.22 now names two readings, A1.17 -> A1.18 and
    A1.18 -> A1.19, both open with the Daisy out. A socket bridge there
    loads the DAC output below its 600 ohm minimum or ties both DAC
    outputs together, and no other reading caught either. The spec checks
    both agai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
2026-10-29 Add CLAUDE.md
    Guidance for Claude Code in this repo: the commands for the board,
    circuit and fault checks, how the circuit check's schematic, part models
    and spec fit together, which documents have to stay in step with the
    spec, and the working rules for checks, waivers and scripted edits.
    It also records the git workflow: commit straight to main with no PRs,
    and use short-lived local branches only for parallel worktree sessions.
2026-10-29 Trim DESIGN.md to the current design and its reasons
    - Passive placement and Routing under the Daisy keep the reasoning and drop
    coordinates, pin orientations and lane order, which the board records.
    - Parts sourcing drops the part tables, which repeat the DigiKey CSV; the
    reasoning bullets stay, plus a note that the Daisy sockets aren't in the CSV.
    - History wording rewritten as current fact; the finished "Layout" open item
    is gone.
    - The 3D model notes move to audio-board/3dmodels/README.md; the Seed3 USB-C
    overhang joins the Mechanical open item.
    631 → 543 lines. Docs only. Circuit check passes (exit 0); every section the
    spec cites is unchanged.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
2026-10-29 Fault check: report two amplifier outputs bridged instead of crashing
    Joining two op-amp outputs put two ideal sources on one net, which made the
    bound engine's matrix singular ("LinAlgError: Singular matrix"), so the
    HP_L-HP_R bridge at U2 (pins 12/14, 0.90 mm) went unchecked. The fault check
    now collects every amplifier output and reports such a join the way it
    already reports two of a part's own supply outputs tied together: possible
    damage, outside the part's model. A test covers it.
    Fault check on the carrier: 223 faults, 0 unchecked (was 1). It now exits 1:
    the HP_L-HP_R bridge is possible damage that no TEST_PLAN reading catches.
    It suggests J4.2 -> J4.3, expect open. Tool tests: 19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
2026-10-29 Test plan: check J4 tip to ring for an OUTL-OUTR bridge at U2
    U2's OUTR (pin 12) and OUTL (pin 14) sit 0.90 mm apart, and solder between
    them ties the two headphone outputs together. No stage 1 reading measured
    between them, so the fault check flagged it as uncaught possible damage.
    TEST_PLAN 1.8 now adds J4 tip -> J4 ring (expect open), and the spec mirrors it.
    Circuit check: 200 pass (was 199), nothing new failing or waived.
    Fault check: exit 0, every damaging fault caught; the bridge is caught by 1.8
    (open -> 0 ohm). Docs and spec only, so no board check.
2026-10-29 Power board: choose the TPA3118D2 speaker amp
    Record the choice in power-board/README.md: its active-high MUTE pin
    matches SPK_MUTE with no inverter, its inputs are differential, and its
    gain must stay at 32 dB or less to keep the 10 kΩ-per-leg input minimum.
    Update DESIGN.md's open items on mute polarity and line-out level to match.
    Docs only; no schematic, board or contract change.
2026-10-29 Power board: record the 3S battery and 4 Ω speakers
    Add the battery (3S lithium, 9.0–12.6 V) and the 10" 4 Ω speakers
    (Jensen MOD10-50 and a "flat" one still to be identified) to
    power-board/README.md, with what they set: the TPA3118D2 at 20 dB, a
    speaker level cap about 5 dB below full scale, roughly 9–17 W into 4 Ω,
    a battery fuse and a suggested 30k/10k BAT divider.
    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
2026-10-29 Power board: record the Talentcell power bank and the Skar FSX10-4
    The battery listing is a Talentcell 100 Wh power bank with its own
    charger and protection, rated 72 W, not a bare 3S pack. The README keeps
    9.0–12.6 V as the worst case until its 12 V output is measured. The
    "flat" speaker is the Skar Audio FSX10-4 (10", 4 Ω).
    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
2026-10-29 Schematic: hide C4 and C5 datasheet URLs
    They were left visible when the DigiKey datasheets were filled in, and
    drew across the Power Input section. Display only, no netlist change.
    Board check: PASS, 0 errors, 23 warnings (unchanged).
    Circuit check: 200 pass, 0 fail, no new waivers.
    Fault check: every damaging fault is caught by the test plan.
2026-10-29 Tools: run them through uv
    The repo root is now a uv project. pyproject.toml lists the tools' only PyPI
    dependencies (matplotlib, numpy), uv.lock pins them, and .python-version pins
    Python 3.12, so a teammate needs only uv and KiCad 10: `uv run
    tools/kicad/<tool>.py ...` builds .venv on first use. KiCad's pcbnew,
    kicad-cli and ngspice are still found by kicadenv.py. CLAUDE.md, the tools
    README and the kicad-* skills now use `uv run`, and the README's requirements
    explain the setup.
    No board or schematic changes. Every tool passes under uv's Python 3.12:
    board check PASS (0 errors, 23 warnings), circuit check and fault check exit
    0, test_circuit_verify 19 tests passed.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
2026-10-29 Tools: add check_all.py to run every check at once
    `uv run tools/check_all.py` finds every .kicad_pcb and every schematic with a
    .verify.py spec, runs the board check, circuit check and fault check on them
    plus the circuit checker's tests, and prints one summary line per check. A
    failing check's full report follows the summary, and the script exits 1. The
    carrier's `--assembly none` lives in BOARD_CHECK_ARGS. It's Python rather than
    Bash so it runs the same on Windows. CLAUDE.md and the tools README point to it.
    No board or schematic changes. Its run on main: board check PASS (0 errors,
    23 warnings); circuit check 200 pass, 2 searched, 6 waived; fault check 48
    damaging faults, every one cha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
2026-10-30 started power board.
2026-11-03 Power board PCB layout completed. Need to wire.
2026-11-03 adding power board.
2026-11-03 Audio board: JLC fab zip, and fix the DigiKey order
    The fab zip holds Gerbers (copper, mask, silk, outline) and Excellon
    drill files (PTH and NPTH separate, oval holes as G85 slots), exported
    with kicad-cli from the current board. No paste layers: hand-soldered.
    Order: J1 moves to Neutrik's own listing (6473-NRJ4HF-ND); the JRH
    listing needs 50 pieces. Adds the two 1x20 sockets for A1 (S6104-ND),
    which the order was missing.
    Checks (check_all.py): board check 0 errors, 23 warnings (21 connector
    silk at the edge, 2 silk line/text below JLC's preferred width);
    circuit check 200 pass, 6 waived; fault check passes; 19 checker
    tests pass.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
2026-11-03 Board: team credits on the back silkscreen
    Three lines on B.SilkS between the Daisy socket rows, each in a band
    clear of the stitching vias and socket pads:
    "B1NARY SOLUTIONS" (1.8 mm), "Designed by Rocco Antoniou" (1.2 mm),
    "ECEN 4610 · 2026-11-03" (1.0 mm). The JLC fab zip is re-exported.
    The rest of the board diff is KiCad re-serialising (-90 written as 270,
    footprint filter properties rewritten); no copper or placement changes.
    Checks (check_all.py): board check 0 errors, 23 warnings (unchanged:
    21 connector silk at the edge, 2 silk line/text width); circuit check
    200 pass, 6 waived; fault check passes; 19 checker tests pass.
2026-11-03 Fab: name the Gerber zip TeamName_gerber.zip, as the capstone manual asks
2026-11-03 Board: via drills to 0.35 mm for the capstone fab's 13 mil minimum
    The course fab needs every hole to be at least 13 mil (0.33 mm). The
    203 small vias go from 0.6/0.3 to 0.6/0.35 mm. The via pad stays at
    0.6 mm so no clearance changes, which leaves a 0.125 mm annular ring
    (JLC's minimum is 0.075 mm). The via preset, the Default net class,
    the minimum hole and annular ring settings and the via rules in
    seed3-carrier.kicad_dru follow, and DESIGN.md records why.
    The credit text strokes go to 1:6 of their height (JLC's legibility
    ratio); they were slightly under it. The Gerber zip is re-exported:
    smallest plated hole is now 0.35 mm (13.8 mil).
    Checks (check_all.py): board check 0 errors, 23 wa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
2026-11-03 Audio board: DigiKey cart upload file
    The file uploaded to DigiKey's cart for the rev 2 build. It matches
    seed3-carrier-digikey.csv except that three resistor lines are rounded
    up to 10, where 10 costs less than the quantity one board needs.
2026-11-05 Tools: fab_export.py and a kicad-fab-export skill for the JLC Gerber zip
    fab_export.py runs the board check, then exports Gerbers and Excellon
    drill files with fixed kicad-cli settings (no X2, Protel extensions,
    silk clipped at mask openings, zones refilled; mm, PTH/NPTH separate,
    G85 slots) and zips them. It ignores the GUI's saved plot settings, so
    the zip is the same whoever runs it. These settings reproduce the
    committed B1NARY_SOLUTIONS_gerber.zip exactly, apart from dates.
    It writes nothing when the board check has errors, writes the zip
    through a temporary file, and reports the outline size and smallest
    holes. --check compares a committed zip with a fresh export; check_all
    now runs i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
2026-11-05 Tools: placement guidance, audio dielectric checks, schematic and Gerber viewers
    Four additions adapted from KiStack's skills (BackplaneWorks/Backplane):
    - kicad-board-edit skill: a "Where parts go" section on placement
    judgement (current loops, placing the least length-tolerant parts first,
    short high-impedance nodes, noisy/sensitive separation, reachable pads),
    tied to this board's parts and DESIGN.md.
    - Circuit check: capacitor dielectrics. parts/passives_mpn.py gives each
    capacitor's rating and dielectric by MPN, decoded from the makers'
    part-numbering schemes. The spec marks audio nets with spec.audio(); a
    Class II ceramic or a capacitor of unknown dielectric on one warns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
2026-11-05 Tools: replace the repo's Python tools with KiCad's own interfaces
    The repo no longer carries scripts. Views, checks, edits and exports go
    through kicad-cli, KiCad jobsets and KiCad's IPC API, following new
    user-level skills in ~/.claude/skills (kicad-view, kicad-check,
    kicad-board-edit, kicad-placement, kicad-schematic, kicad-fab-export,
    kicad-design-review), so they carry to the next project.
    Removed: tools/ (board view/check/edit, fab and Gerber export, the
    circuit and fault checkers, part models), check_all, pyproject.toml,
    uv.lock, .python-version, seed3-carrier.verify.py, the Python interface
    contract and the repo's .claude/skills. Git history keeps them (39d3afc).
    Added: audio-board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
2026-11-05 Submitted power board rev 1
2026-11-05 Docs: the power board now has its rev 1 KiCad project
2026-11-05 CLAUDE.md: the KiCad skills now live in roccoagain/kicad-agent-skills
2026-11-05 CLAUDE.md: install the KiCad skills from their repo when they're missing, wherever the clone lives
2026-11-05 CLAUDE.md: install the KiCad skills with npx skills when they're missing
2026-11-05 One DigiKey order for both boards
    amp-digikey-order.csv holds one build of the audio board and the power
    board, plus the power board's experiment and alternative parts, with a
    DigiKey part number on every line. amp-digikey-cart.csv is the same
    order in DigiKey's cart upload format. Parts both boards use (1984617,
    1984633, C1206C105K5RACTU, C0805C105K5RACTU, RC1206FR-0710KL,
    RC1206FR-07100KL) are single lines. 64 lines, about $104.
    Every line was checked through the DigiKey API: cut tape or single
    pieces, minimum order 1, in stock, except TPS3808G50DBVR (none at
    DigiKey in any package, so it backorders).
    Substitutes for parts out of stock or sold only by the reel:
    - EEU-FR1E101 -> EEU-FM1E1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
2026-11-05 DigiKey order: TPS3808EG50DBVR for the power board's U3
    DigiKey has no TPS3808G50 in any package. TI's TPS3808E is its
    successor, and both datasheets (SBVS050N, SNVSCE0B) give the same DBV
    pinout (1 RESET, 2 GND, 3 MR, 4 CT, 5 SENSE, 6 VDD), the same 4.65V
    threshold for G50/EG50, an open-drain RESET, a 90k internal MR pull-up
    and 20ms delay with CT open, which is how U3 is wired. The E part is
    rated to 6V on VDD (abs max 6.5V) instead of 6.5V (7V); U3 sits on
    +5V_RAW.
    Every line of the order is now in stock at DigiKey with minimum order 1.
2026-11-05 DigiKey order: 10 of the 100k 1206 and 10k 0805 resistors
    DigiKey refused both lines because 10 cost less than the 6 and 4
    needed. No other line in the order has a cheaper higher quantity.
2026-11-05 DigiKey cart: 10 of the 100k 1206 and 10k 0805 resistors
    The previous commit changed the order but not the cart file.
2026-11-05 DigiKey order: leave out the TPA3128 alternative
    The order keeps the power board's main parts and its experiments, but
    not the alternative amplifier (TPA3128D2DAPR, $2.77).
2026-11-05 DigiKey order: NKK S1B power switch instead of the S301T
    The S1B ($2.80) is from the same NKK S series as the S301T ($15.78):
    the same 12.5mm M12x1 panel hole and lever, SPST on-off, 30V DC. It is
    rated 5A AC/DC instead of 20A DC, which covers the 3.15A fuse (and the
    5A experiment) on a 12V supply, and has solder lugs instead of screw
    terminals. The order comes to about $88.50.
2026-11-05 README, CLAUDE.md: the power board's rev 1 has been ordered
2026-11-05 DigiKey order: note that the S1B switch is obsolete
    DigiKey has 136 in stock, enough for this build.
2026-11-05 CLAUDE.md: use the renamed kas-* skills, and keep away from KiStack's kicad-* ones
    The skills in roccoagain/kicad-agent-skills are now kas-*, renamed to avoid KiStack's kicad-* names, with seven new
    ones. Schematic changes reach the board with kas-board-edit's sch_to_board.py, which also restores the 3D models
    the API drops when it rotates a part. KiStack's layout-placement move script empties footprints on stock KiCad
    10.0.5, so don't use it here. The corrected JLC limits pass (it used to check only copper clearance) reports nothing
    new on rev 2.
2026-11-05 CLAUDE.md: the skills are named kicad-* again
2026-11-05 Power board: parts list and schematic fields match what was ordered
    DigiKey_Import.csv is now the power board's share of the DigiKey order
    placed on 2026-11-05: one build, with DigiKey part numbers, and the
    experiment parts that were ordered. DigiKey_Optional_Capacitors.csv is
    folded into it (C4 C6). The TPA3128 alternative wasn't ordered and is
    gone.
    The schematic and board fields (MPN, Manufacturer, Purchase_Note, and
    U3's Value) now name the parts that were ordered:
    - U3 TPS3808G50DBVR -> TPS3808EG50DBVR
    - C4 C6 C11 C12 EEU-FR1E101 -> EEU-FM1E101H
    - C8 C9 GRM31MR71E155KA88L -> KEMET C1206C155K5RACTU
    - D1 BZT52C12-7-F -> MCC BZT52C12-TP
    - R8 R10 RC1206FR-072K2L -> RC1206FR-132K2L
    The pane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
2026-11-06 Docs: record the power board's BAT divider; call the carrier the audio board
    DESIGN.md records the power board's rev 1 BATT_SENSE divider: R2/R3
    (30k/10k, 1 %) gives 0.25 from 7.5 kOhm, so Daisy pin 25 reads VBAT / 11
    (1.15 V at 12.6 V, 0.82 V at 9.0 V; within +/-2.4 % worst case). The open
    item is closed, and the power board README points to where it is recorded.
    The docs now call audio-board/rev2 "the audio board" instead of "the Seed3
    carrier" or "the carrier". KiCad file and library names (seed3-carrier.*,
    Seed3_Carrier.pretty) are unchanged.
    Docs only: no schematic or board change, so no ERC/DRC run.
2026-11-07 Rev 3: start the combined board as a 4-layer copy of audio rev 2
    audio-board/rev3/ is rev 2's KiCad project, unchanged except:
    - 4 copper layers (In1.Cu, In2.Cu added), with JLC's JLC04161H-7628
    1.6 mm stackup written into the board's stackup table;
    - the jobset plots In1.Cu and In2.Cu;
    - the library tables also reach power-board/Halliquest_Power.
    Rev 3 will merge the power board in (plan: power sheet as a sub-sheet,
    4-layer JLC board, DFR0571 kept off-board).
    Checks (kicad-check): ERC 0 errors, 0 warnings (lint: the same 2 R26/R28
    text overlaps as rev 2). DRC 0 errors, 21 warnings (the expected J1-J6
    silk_edge_clearance), 0 unconnected, 0 parity. JLC multilayer limits
    clean; recommended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
2026-11-07 Rev 3: merge the power board's schematic in as a sub-sheet
    power.kicad_sch is power board rev 1's sheet, its parts renumbered +100
    (U101 TPA3118D2, U103 TPS3808, Q101 IRF4905, J101 barrel jack...). The
    audio sheet stays the root, unchanged except where the boards met:
    - audio J5/J6 and power J3/J4 (rev 1 numbers) are gone; the power sheet's
    hierarchical labels meet the audio nets at the "Power" sheet symbol:
    +5V_AUDIO -> 5V_IN, BAT_MON -> BATT_SENSE_CONN, SPK_MUTE, Line+ ->
    LINE_OUT, Line- -> LINE_REF. GND is one net.
    - one GND PWR_FLAG dropped (the power sheet's at the battery jack stays).
    - notes and title block updated for rev 3.
    No other circuit change: the netlist matches audio re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
2026-11-07 Rev 3: reverse protection on J107, PBTL ERC exclusions
    Design review of the merged schematic (kicad-design-review), decided with
    the user:
    - J107 (the DFR0571's 5 V output, a screw terminal) wired backwards put
    -5 V on all of +5V_RAW: U103 (TPS3808, VDD -0.3 V min) and the display
    on J105 had no protection; Q1 only covers the audio branch. Added Q102
    (AO3401A, gate to GND, like Q1) from the new net +5V_DFR (J107 pin 1,
    and U102's off-board 5V_OUT) to +5V_RAW, plus a PWR_FLAG on +5V_RAW.
    Q1 stays, so the audio circuit is unchanged.
    - U101's two pin_to_pin ERC errors are the PBTL ties (SLOS708G 7.4.1:
    OUTPR-OUTNR, OUTPL-OUTNL): excluded in the project, with the reason.
    - Accepted,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
2026-11-07 Rev 3: lay out the power band and route the combined board
    Board: 100 x 110 mm, 4 layers. Rev 2's analog band and its routing are
    kept as they were (shifted 20 mm toward the front edge); the power band
    behind the Daisy holds the power board's parts:
    - class D in the rear-right corner: U101 outputs face L101/L102 and the
    speaker terminal J102 on the right edge; bootstrap caps at the output
    pins; wide OUT traces; PVCC bulk and HF bypass at both PVCC pin pairs,
    linked through a PVCC pour on B.Cu; AVCC rail with C116/C115/R106;
    thermal vias in U101's pad and a B.Mask opening to solder it from the
    back.
    - battery entry along the rear edge: J101 (12 V jack) at the corner,
    F101, SW101,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
2026-11-07 Rev 3: design notes, changes, parts order; README and CLAUDE.md
    - audio-board/rev3/DESIGN.md: the combined board as it stands. Rev 2's
    unchanged signal-path sections are carried over verbatim; new sections
    for the power section (sheet 2), the links between the sheets, the
    connector environment with the new terminals, the 4-layer stackup,
    isolation (with the measured distances), placement, routing and rules,
    and "Decisions" (PBTL ERC exclusion, Q102, no 5 V alone on J107, FAULTZ
    latch, J106 reversal, J102 pin swap, AUX distance 48 mm, solid ground
    pads at U101/C110, VBAT branch on In2, 0.8 mm references).
    - audio-board/rev3/CHANGES.md: net difference from audio rev 2 and power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
2026-11-07 Rev 3: bring-up test plan; correct the DFR0571 and SDZ notes
    - audio-board/rev3/TEST_PLAN.md: rev 3's bring-up and test plan, from
    rev 2's (stage 1A keeps its item numbers) with power and class D
    stages added. Powered only from current-limited 12 V on J101 with the
    DFR0571 connected; readings computed from the rev 3 netlist, with the
    jumper-dependent ones marked.
    - Corrections found while writing it, checked against the schematic:
    - with PVCC at 0 V, SDZ reaches ~4.5 V through R109 + R110 (not 4.9 V)
    and each of SDZ and MUTE takes at most ~0.36 mA (not 2 mA); the
    no-5-V-on-J107 rule stands.
    - the DFR0571 is non-isolated: J106's wires swapped short the battery
    through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
2026-11-07 Rev 3: floorplan B, the Daisy upright between audio and power
    Re-lays the combined board around an upright Daisy (USB on the rear
    edge): audio on its left and in front of it, the battery entry and
    class D on its right. 122 x 78 mm (was 100 x 110).
    - Kept whole with their routing: the power section (moved 22 mm right),
    rev 2's input buffer + J1, J2 + D2/D3 and the U2 block + J4 (moved
    32 mm rearward), and the left-edge harness/display block (in place).
    - Placed new: the audio 5 V filter column with Q1/C4/C5, the AUX sum,
    the mute/sense columns beside the Daisy's pins, the speaker-send
    filter next to C108/C109, holes and fiducials.
    - Supply crossings go around the Daisy's USB end, one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
2026-11-07 Rev 3: restyle the back-side credits
    The credits on B.SilkS move to the empty area behind the front-right
    corner and are set in Orbitron (Black for the name, Bold for the rest),
    with a rule under the name. The font is embedded in the board file, so
    KiCad plots it the same on any machine. All text is at least 1.0 mm.
    Checks (KiCad 10.0.8): ERC unchanged (schematic untouched). DRC 0
    errors, 0 unconnected, 0 parity; 36 silk_edge_clearance (expected) and
    3 fiducial lib_footprint_mismatch (this machine's library). JLC limits
    0; JLC recommended unchanged from the previous commit. Fab zip
    re-exported.
    Claude-Session: https://claude.ai/code/s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
2026-11-07 Rev 3: name each test point's net on the silkscreen
    Every test point now shows its reference with its net beside it (1.0 mm):
    TP101 VBAT, TP103 PVCC, TP104 SDZ, TP109 FAULT, TP106 5V RAW, TP1 HP DET,
    TP102/TP105/TP107/TP108 GND. TP102 moves 4 mm left (bare pad, GND) to
    make room; R12's label moves beside R12.
    0. JLC recommended: as before, with 34 0.8 mm references (was 35).
    Fab zip re-exported.
    Claude-Session: https://claude.ai/c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
2026-11-07 Rev 3: black solder mask, white silkscreen
    The stackup now sets black mask on both sides and white silkscreen, so
    the 3D view matches the order. Board Setup's minimum mask web is
    0.13 mm (JLC's figure for black mask); the narrowest web on the board
    is 0.20 mm at U101's pins, so the plots merge nothing.
    Checks (KiCad 10.0.8): ERC unchanged. DRC 0 errors, 0 unconnected,
    0 parity; 36 silk_edge_clearance (expected) and 3 fiducial
    lib_footprint_mismatch (this machine's library). JLC limits 0; JLC
    recommended unchanged. Fab zip re-exported.
    Claude-Session: https://claude.ai/code/session_01CuqBZLwSiVag4WL4RcWo5H
2026-11-07 Rev 3: re-place the silkscreen designators
    Every visible reference except the test points (set in the previous
    commit) was re-placed by a throwaway pcbnew pass: upright, beside its
    own part (above first), never over a pad, another label, footprint silk,
    a tall part's body or its own body, and nearer its own part than any
    other. A label moves only when such a spot exists; 81 moved, the rest
    already sat in their best spot. The Daisy's label now sits outside the
    module, where it stays visible once A1 is fitted. 0.8 mm references:
    30 (was 34).
    lib_footprint_mismatch (thi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
2026-11-08 Rev 3: drop the B1NARY SOLUTIONS logo from the back credits
    The back silkscreen keeps "GUITAR AMP – REV 3", both names and
    "ECEN 4610 – 2026-11-07", moved up 3 mm into the space the logo and
    its divider line left. Fab zip re-exported.
    Checks (unchanged from 0beb750):
    - ERC: 0 errors, 2 warnings (U101 PBTL output ties)
    - DRC: 0 errors, 36 warnings (expected silk_edge_clearance), 0 unconnected, 0 parity
    - JLC limits: 0; JLC recommended: 48 warnings, the same front-side silk findings as before
2026-11-08 Rev 3: C18 RF filter at U1A's input; AM2-AM0 through bridged jumpers
    - C18 (100 pF C0G, same part as C1) from U1A's + input to GND, below R2:
    filters RF (the display's Wi-Fi bursts) at the op-amp pin, a 1.6 MHz
    low-pass with R2.
    - U101's AM2/AM1/AM0 now reach GND through JP106-JP108, solder jumpers
    bridged in copper on the back (vias beside pins 13-15). Same circuit as
    before; cutting one moves the class D's switching frequency if it beats
    with U2's charge pump. AMP_MUTE's track moved 0.3 mm left to fit the vias.
    - Order and cart: C1's line now 2 (C1 C18). DESIGN.md, CHANGES.md and
    TEST_PLAN.md updated (new checks 0.12, 4C.10, 6.14 Wi-Fi buzz).
    Checks:
    - E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
2026-11-08 Rev 3: 0603/0805 passives on standard reflow footprints
    - Resistors are 0603 (R105 stays 2512). Capacitors are 0603 up to 220 nF
    and 0805 from 680 nF, where DC-bias loss matters; C7 (47 uF on VREF)
    stays 1210. KiCad's standard footprints replace every _HandSolder one.
    - 72 parts swapped in place: same position, rotation and reference text,
    with short stubs from the old track ends to the new pads. Values and
    nets unchanged (pin-to-net list identical).
    - New in-stock DigiKey parts for every resized passive (MPN, DigiKey,
    Datasheet fields on both sheets). Stackpole RMCF0603 for 10k, 100k and
    10R, since YAGEO's 0603 versions are out of stock. C108/C109 now 16 V
    (they sit at 3 V); C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
2026-11-08 Rev 3: LCSC numbers and JLC assembly files
    - Every SMD part has an LCSC field (91 parts). Semiconductors, beads,
    inductors and parts with no Basic equivalent use the MPN itself; the
    resistors and most capacitors use JLC Basic parts of the same value,
    size, tolerance and dielectric with equal or higher voltage. D1-D5 are
    C19224 (Nexperia PESD5V0S1BA, SOD-323). 15 Extended parts.
    - jlc-assembly.kicad_jobset (CPL SMD-only), jlc-rotations.csv (empty) and
    fab/assembly/ BOM + CPL. jlc_asm.py check: every placed part in both
    files with an LCSC number, top side only (Economic assembly).
    - C121/C122 moved 1.1 mm in from the right edge for JLC's 2.5 mm
    part-to-edge rule; the assembly edg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
2026-11-08 Rev 3: C0G C2, ferrite bead on the guitar input, RF caps on the display UART
    - C2 is 47 nF C0G (KEMET C0805C473J3GACTU, 0805, LCSC C22402129), was 1 uF
    X7R: C0G isn't piezoelectric, so knocks don't become signal at the 1 MOhm
    input. High-pass 0.16 Hz -> 3.4 Hz. No 100 nF C0G 0805 in stock.
    - FB1 (Murata BLM18HG601SN1D, GHz-band bead, LCSC C85830) between C1 and C2:
    C1, FB1 and C18 block Wi-Fi RF before the input traces. Placed below C2;
    the jack side keeps GTR_TIP (J1, D1, C1).
    - C19/C20 (10 pF C0G, LCSC C1634 Basic) on DISPLAY_UART_TX/RX, the Daisy
    side of R8/R9: ~60 dB at 2.4 GHz with the 10k, TX edges unaffected, RX
    +0.1 us (230400 baud limit unchanged).
    - Order (50 lines), ca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
2026-11-08 Rev 3 shrink, stage A: Daisy and right side 10 mm left (WIP)
    First step toward a board under 100 x 100 mm. The board outline is
    unchanged in this commit; documents are updated at the final stage.
    - The 5 V filter column (C104, JP102, FB101, JP101, Q1, C5, C4, C105,
    TP107) and H1 moved into the free space left of the Daisy.
    - A1 and every part right of it moved 10 mm left as one block, with
    their tracks, vias, the PVCC pour and silkscreen; in-block routing is
    unchanged. Crossing tracks were removed and re-routed by hand:
    VBAT_PROTECTED (In2), +5V_RAW (B.Cu) and +5V (F.Cu) round the
    Daisy's rear end; +5V analog feed (B.Cu/In2); 5V_IN, CAP_BANK_A;
    AUDIO_IN_1 (F.Cu, left of the Dais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
2026-11-08 Rev 3: 100 x 78 mm; SMD fuse; drop Q1, R23 and the second battery divider
    Board under 100 x 100 mm (was 122 x 78), following stage A.
    Circuit:
    - F101 is a Bel 0683G3150-01 (3.15 A slow-blow, 4818 SMD, 2 kA DC
    interrupting) instead of a T3.15A 5x20 fuse in a Bulgin FX0457 holder.
    New footprint Seed3_Carrier:Fuse_Bel_0683G_4818 from the datasheet's
    reflow land pattern. Hand-soldered (no JLC stock), excluded from the CPL.
    - Q1 removed: FB101 feeds +5V directly (Q102 protects all of +5V_RAW).
    - R23 removed: Q2's drain is on SPK_MUTE.
    - R13/R22 removed, R102 30k -> 100k: R102/R103 give VBAT/11 on pin 25
    directly (same firmware constant), 9.1 kOhm source.
    Layout:
    - Rear edge: SW101, F101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
2026-11-08 README: show rev 3's renders
    audio-board/rev3/render/top.png and bottom.png (3D renders with the board's
    black mask and white silkscreen, transparent background) are linked at the
    top of the README as the latest board. CLAUDE.md now says to overwrite them
    in the same commit as any rev 3 board change, with the render commands.
2026-11-08 Rev 3: U2 supply filter, C0G speaker input caps, FAULTZ to the Daisy; floorplan accepted
    - R29 (2.2 ohm) + C21 (10 uF) give U2 its own supply, HP_5V, so its
    600 kHz charge pump stays off +5V (U1, VREF, the Daisy).
    - C108/C109: 470 nF C0G 1206 (Murata GRM31C5C1E474JE01L), were 1.5 uF
    X7R 0805. Not microphonic; speaker input corner 1.7 Hz -> 5.6 Hz.
    1 uF C0G isn't stocked in 1206 or 1210.
    - R114 (18k) to GND divides FAULTZ's pull-up to ~3.2 V; FAULTZ reaches
    Daisy pin 32 through a sixth sheet pin (AMP_FAULTZ).
    - R29/C21 above C13, left of FID2: +5V from the via at R18, HP_5V down
    to U2's bus through one In2 hop under HP_SOURCE. U2's old +5V In2 feed
    removed; the t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
2026-11-08 DESIGN: name Daisy pin 32's port (D25, PA0) for the FAULTZ read
    KiCad's Daisy Seed symbol labels pin 32 SAI2_SD_B; libDaisy's daisy_seed.h has
    D25 = PA0, and PA0's SAI2 alternate function is SAI2_SD_B. The same chain
    matches the pins already in use (23 = PA3, 25 = PA7, 28 = D21/PC4).
2026-11-09 Rev 3 schematic review: fix stale sheet notes, hide datasheet URLs on sheet 2
    No electrical change: the netlist and BOM are identical before and after.
    Sheet 1 notes brought in line with the circuit:
    - Power input: Q1 is gone; +5V comes from FB101, Q102 is the protection.
    - Sheet 2 summary: R102/R103 are 100k/10k (VBAT / 11 from 9.1k), no
    R13/R22, net names BATT_SENSE and +5V, and the AMP_FAULTZ link.
    - Headphone amp and output mute: SHDN is on HP_5V (R29/C21), not +5V.
    - Speaker send: R21 sits beside R11; pin 19's DC check is TEST_PLAN 6.16.
    Sheet 2: 30 Datasheet fields were visible and printed over the parts;
    hidden. R114's and U103's reference and value moved off their bodies
    and pins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
2026-11-09 Rev 3 schematic: redraw sheet 2, short STE notes on both sheets
    Sheet 2 (power.kicad_sch) is redrawn on A3 in dashed signal-flow blocks
    (battery input, 5 V buck, 5 V filters, speaker amplifier, amplifier
    supply, output filter, battery monitor, shutdown/mute/fault, test
    points), with wires in place of most labels and the hierarchical labels
    inside their blocks. Every part keeps its UUID; the netlist is
    pin-for-pin identical to the previous commit.
    - Sheet 2 nets take sheet 1's names: BAT_MON, Line+, Line- are now
    BATT_SENSE, LINE_OUT, LINE_REF (sheet pins renamed to match).
    - Value fields hold values, not descriptions (R105 0R, JP101/JP103
    BYPASS, JP102/JP104 BULK, L101/L102 10uH, FB101/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
2026-11-10 Rev 3: keyed J106, Schottky clamps on U101's SDZ and MUTE, R30 before Daisy pin 32
    Three fixes from the schematic review's follow-up:
    - J106 is a JST S2B-XH-A (keyed) instead of a screw terminal like J107.
    Swapping the DFR0571's two wire pairs put 12 V on its 5 V output and,
    through the buck's body diode, on +5V_RAW and +5V (U1, U2, U103, the
    Daisy, the display). Only the module's input cable fits J106 now.
    - D102/D103 (NSVBAT54HT1G, SOD-323) from AMP_SDZ and AMP_MUTE to PVCC.
    At switch-off C125/C124 held SDZ and MUTE above a falling PVCC and
    discharged (~1 mA) into U101's unrated protection diodes.
    - R30 (1k) between AMP_FAULTZ and Daisy pin 32, in case firmware drives
    PA0 while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
2026-11-10 Rev 3: U2 is a TPA6130A2 (I2C headphone amp) instead of the MAX9722A
    JLC assembles rev 3, so U2 no longer needs to be a hand-solderable
    TSSOP. LCSC had 76 MAX9722AEUE+ at $5.03 and 3,842 TPA6130A2RTJR at
    $0.99 (C130046, checked 2026-11-09). The swap also adds:
    - a hardware headphone mute: HP_SD from Daisy pin 27 with R34 (100k)
    to GND, so U2 is off with the Daisy out, booting or in reset;
    - I2C volume and mute (address 0x60) on Daisy pins 12/13, R32/R33 2.2k
    pull-ups to the Daisy's 3V3_D (pin 38);
    - inputs rated -2.5..3.6 V with the supply off, so audio from a
    Daisy on USB alone can't harm U2.
    Circuit: signal on the - inputs through C10/C11, + inputs to GND
    through C22/C23, all 470 nF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
2026-11-10 Rev 3: U1, C104, C106 values match their part numbers; drop the unused MAX9722A symbol
    - U1's value is TLV9061QDBVRQ1 (was TLV9061IDBVR), the part in its MPN field and the order.
    - C104 and C106 (not fitted) read "100u 25V" (was "100u 10V"): EEU-FM1E101H is a 25 V part.
    - Sheet 1 no longer carries the cached seed3-carrier:MAX9722AEUE symbol, which no part used.
    No net, footprint or part changes. The board takes the three values (board.py sync); the fab zip,
    assembly BOM and CPL (U1's comment only) and the top render are re-exported.
    Checks: ERC 0 errors, 0 warnings. DRC with parity 0 errors, 29 warnings (the expected
    silk_edge_clearance), 0 unconnected, parity 0. JLC limits 0. JLC recommen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
2026-11-10 Rev 3 docs: record what the Seed3 and DFR0571 datasheets settle
    - USB and VIN: the Seed3 datasheet's Figure 1.0 shows a diode from USB VBUS and one from VIN into
    the module's regulators, so USB can't drive pin 39. DESIGN.md said this was only inferred.
    TEST_PLAN 5.0 stays as a confirmation, with the reason for its expected reading.
    - DFR0571: DFRobot's own datasheet (2018-08-07) gives the figures DESIGN.md listed as a reseller's
    and unverified: 8-28 V in, 5 V +/- 0.1 V, 3 A peak, < 50 mVpp ripple, 0.5 mA no load, not isolated.
    It names no short-circuit or reverse protection; the open item is narrowed to that.
    - Speaker send: a DC level on pin 19 would damage nothing (C108 blocks it,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
2026-11-10 Docs: fix stale claims found in a review of all the markdown
    A review of every markdown file against the netlists, BOMs, orders and the Seed3 and DFR0571
    datasheets. This fixes rev 3's files, the README and CLAUDE.md; rev 2's files and the power board
    README are untouched.
    Rev 3 TEST_PLAN.md
    - 1.19: A1.27 is HP_SD (R34 to GND), no longer open; only A1.26 is checked there.
    - 7.5: C10/C11 are C0G, not class II ceramics.
    - 4C.5 and 8.2: unmute is ~4 ms (R108 x C124 = 2.2 ms; R23 is gone), not ~6 ms.
    - 3C limit: 3B draws <= 5 mA since the TPA6130A2, not <= 12 mA.
    - 3C.3: upper bound 4.55 V. Options table: the 1206 spares don't fit rev 3's R106 and C121/C122.
    - Sheet 1 is no longer described as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
2026-11-10 Rev 2 docs: fix stale claims found in the markdown review
    Text corrections only; the ordered rev 2 board and its files are unchanged.
    rev2/DESIGN.md
    - Power rev 1 has no low-battery cutoff (also in CHANGES.md).
    - USB doesn't drive VIN: a diode from each on the module (Seed3 datasheet, Figure 1.0).
    - The AUDIO_IN_2 node is ~400 ohm with R5 at 470 ohm, not ~2 kohm.
    - DC on pin 19 reaches J5 and R12, not the speaker amp (the power board's C8/C9 block it).
    - The display and the Daisy share the power board's 5 V on separate filtered branches.
    - Raising R25/R27 to 20k is about -4 dB overall, not -6 dB. Watchdog mute is ~10-20 ms.
    - Figure 3.9 suggests, not proves, 0 V DC on pin 18. VREF's noise s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
2026-11-10 CLAUDE.md: search every document after a design change; cite datasheet checks
    Two working rules from the markdown review. Most stale claims were echoes of an old value in a
    file or section the change didn't touch; a few were statements about a datasheet or another board
    that nobody had checked.
2026-11-10 Rev 3 DESIGN.md: condense, one home per fact
    792 lines and 14,200 words become 431 lines and 6,500 words. Every section heading other files
    point to is kept (only the "U2 (WQFN-20)" layout subsection merged into placement), and every
    part reference survives except the removed parts (R13, R22, R25-R28), C103/C123, the mounting
    holes and TP103.
    Cut: the same fact told in several sections (the C0G list, R34, running from USB), dated narrative
    of how the design got here, stock counts and prices, the layer-by-layer and part-by-part track and
    position lists that the board file holds, and the footprint verification notes. Kept: each block's
    circuit and reasons, every number with its source, the co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
2026-11-10 Docs: condense the remaining design notes, change lists and test plans
    Same aim as the rev 3 DESIGN.md pass: one home per fact, no history, no restated reasons.
    No fact, number, step or expected reading was changed; each file was compared with its old
    version for step ids, headings, part references and numbers.
    Lines / words, before -> after:
    - audio-board/rev3/TEST_PLAN.md 622 / 15,364 -> 581 / 13,228. All 201 step rows kept. The two
    circuit-summary tables went (DESIGN.md is their home), with history notes and working in cells.
    - audio-board/rev3/CHANGES.md 99 / 1,666 -> 66 / 938
    - audio-board/rev2/DESIGN.md 583 / 10,762 -> 521 / 8,053. No heading or part reference lost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
2026-11-10 Docs: resolve the inconsistencies the condensing turned up
    - Rev 3 speaker full scale is 9.7 Vrms in DESIGN.md, as in the test plan: 1 Vrms x 0.974 (R11
    into R12 and U101's 60 kohm) x 10. Test 4C.6 says its 15.5 W is at the 12.0 V bench supply
    (DESIGN.md's 17 W is a full 12.6 V pack).
    - Rev 2 DESIGN.md: the MUTE pull-up limit is the 5 V rail (5.25 V) in both places, and the
    firmware requirements carry the 5 dB speaker cap the open items already assumed.
    - Rev 2 test plan: the results log has fields for the readings steps 5.16-5.19 and 6.6 ask for.
    - Power board README: the contract stays "10 kohm or more per leg"; the worked level now matches
    it (0.91 Vrms, -0.8 dB), with the 0.83 Vr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
2026-11-10 Make the combined board its own project: amp-board/; freeze the ordered boards in legacy/
    The board that was audio-board/rev3 is now the amp board, the only live design,
    and no longer has to match the two boards it grew out of.
    - amp-board/: the project is renamed amp-board.kicad_* and has its own library
    (lib/amp-board.kicad_sym, lib/amp-board.pretty, lib/3dmodels) with only the
    symbols and footprints it uses, so its tables no longer reach outside the folder.
    - legacy/: audio board rev 2, power board rev 1 and their joint DigiKey order,
    as ordered on 2026-11-05. Only moved; one path in rev 2's DESIGN.md follows.
    - Parts: the schematic's DigiKey, MPN, Manufacturer and Purchase_Note fi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
2026-11-10 Amp board: back silkscreen reads "GUITAR AMP – REV 1"
    It read REV 3 from when the board was called audio board rev 3; the title blocks
    already say revision 1. Text only, same font, size and position. The save through
    KiCad's Python also wrote an explicit 0.15 mm thickness on some text items.
    render/bottom.png re-rendered.
    DRC with parity: 0 errors, 0 unconnected, 0 parity issues, the 29 expected
    silk_edge_clearance warnings. Schematic unchanged.
2026-11-10 Amp board: clean parts data, trim the documents, stop waiting on the legacy boards
    Parts data (schematic fields only; no circuit or copper change):
    - Values are the bare value on both sheets (100nF, 10k). The power sheet's
    ratings and tolerances left the value field; each capacitor's rating is in its
    hidden Voltage field (the part's own rating).
    - The five order lines that weren't schematic parts are symbols marked "not on
    board" on sheet 2 (X101-X109: Daisy sockets, J106 housing and lead, four
    shunts, panel switch). order-extras.csv is gone.
    - The Daisy (A1) and the test points are out of the BOM. The generated DigiKey
    order now has a part number on every one of its 53 lines.
    - Bo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
